cafe-alpha/wascafe/README.md

# wascafe

Wascafe ?
cafe-alpha's sandbox for wasca project, where I put sources for each PCB revision in a separate folder, and also where I learn how to use github related things.

Wasca ?
Sega Saturn multipurpose cartridge, still in development phase.
It will mimic Power Memory / Backup RAM, 1MB ROMs from KoF and Ultraman, and 1M/4M RAM expansion.
More than that, it should emulate Sega Saturn modems, and launch any 3rd party code, for example PseudoSaturn Kai.
Cart is based on Altera MAX 10 FPGA with external SDRAM and internal Nios II soft CPU. 

Wasca main repository can be found here : https://github.com/hitomi2500/wasca/
