cafe-alpha/wascafe/v11/README.md

Second revision, by hitomi2500, Autumn 2015

Specs :
 - MAX10 FPGA (10M04SA or higher)
 - 32MB SDRAM/DDR support
 - USB and bluetooth interfaces
 - STM32 micro controller

Features :
 - Cartridge backup memory (volative)
 - SD (not SDHC) card access
 - RAM expansion (untested ?)

Pictures :
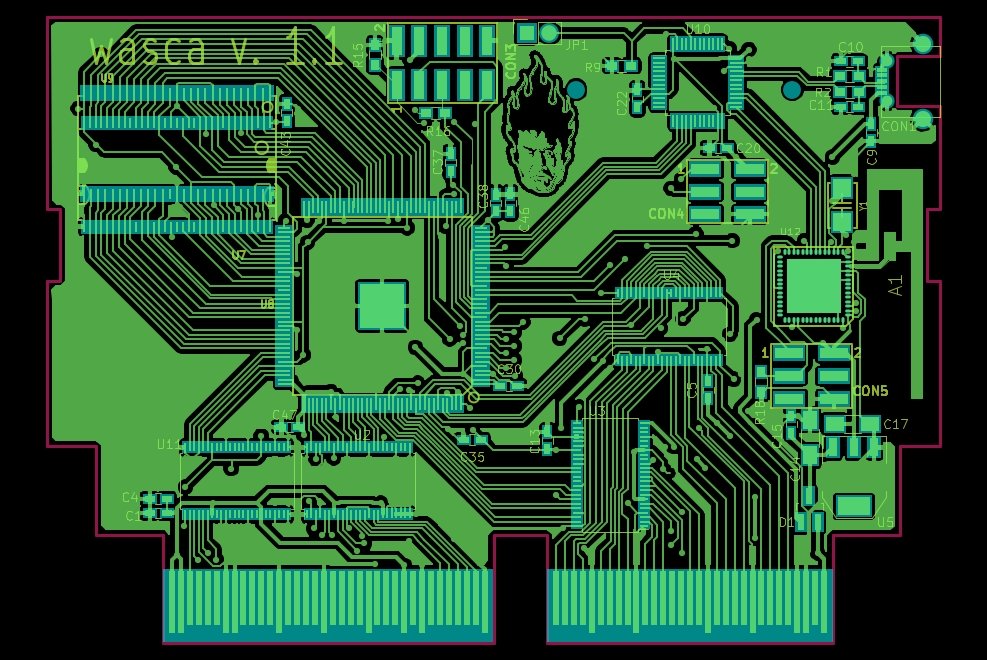
[picture p9: v11/pictures/top.png]

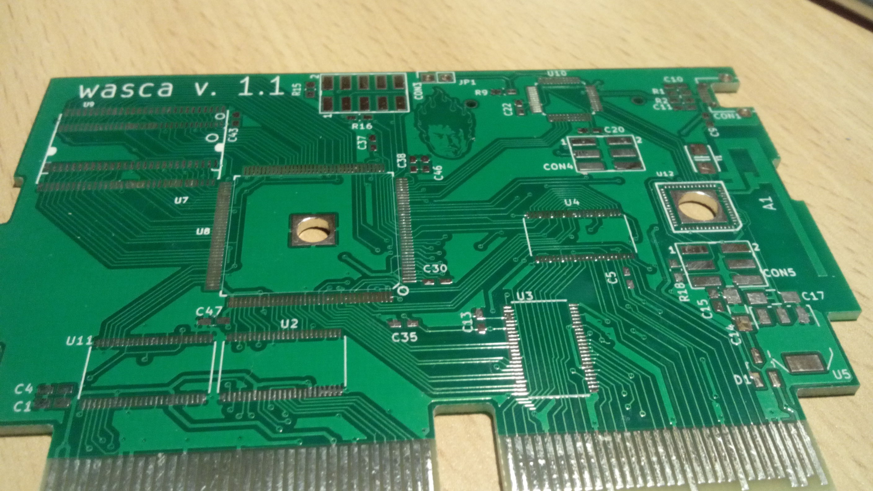
[picture p10: v11/pictures/IMG_20151030_221556_1a.jpg]

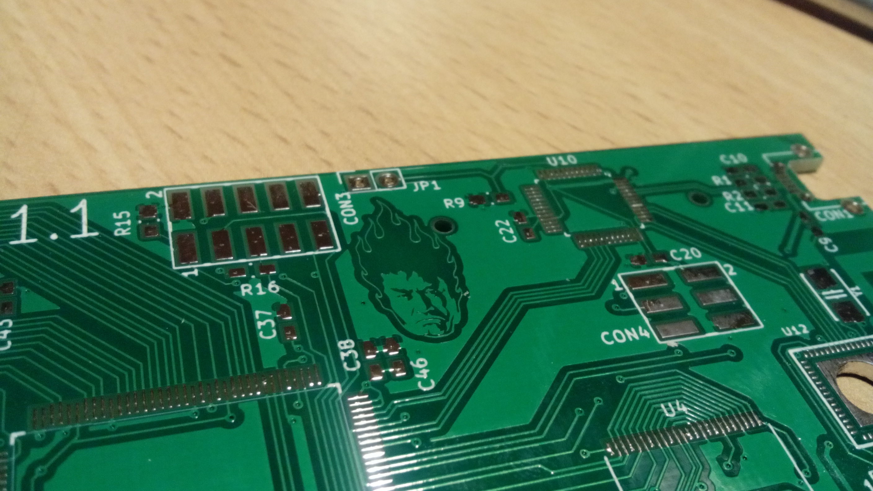
[picture p11: v11/pictures/IMG_20151030_221501_1a.jpg]

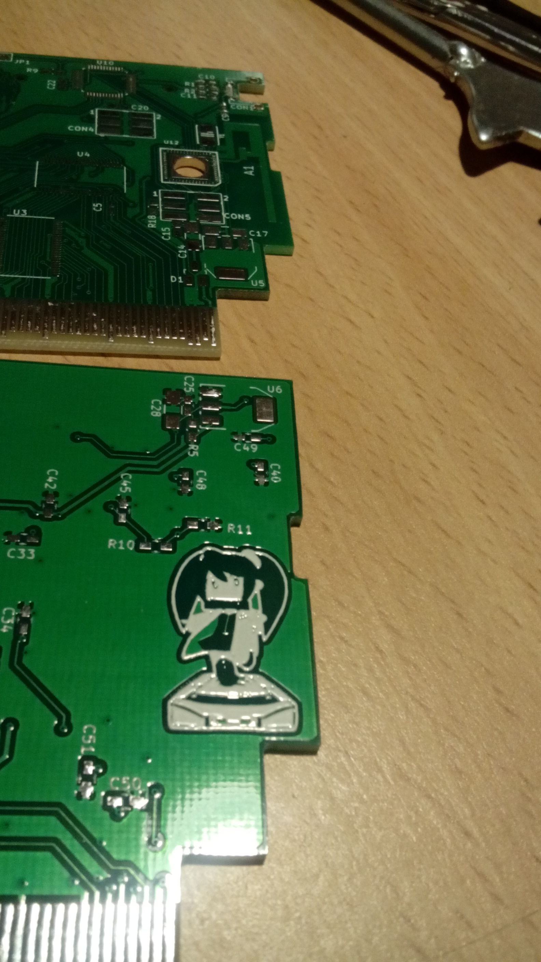
[picture p12: v11/pictures/IMG_20151030_221530_1a.jpg]
