cafe-alpha/wascafe/v10/README.md

First revision, by hitomi2500, Summer 2015

Specs :
 - MAX10 FPGA (10M04SA or higher)
 - 32MB SDRAM support
 - UART + USB interface

Features :
 - Cartridge backup memory (volative)
 - SD (not SDHC) card access
 - RAM expansion (untested ?)

Pictures :
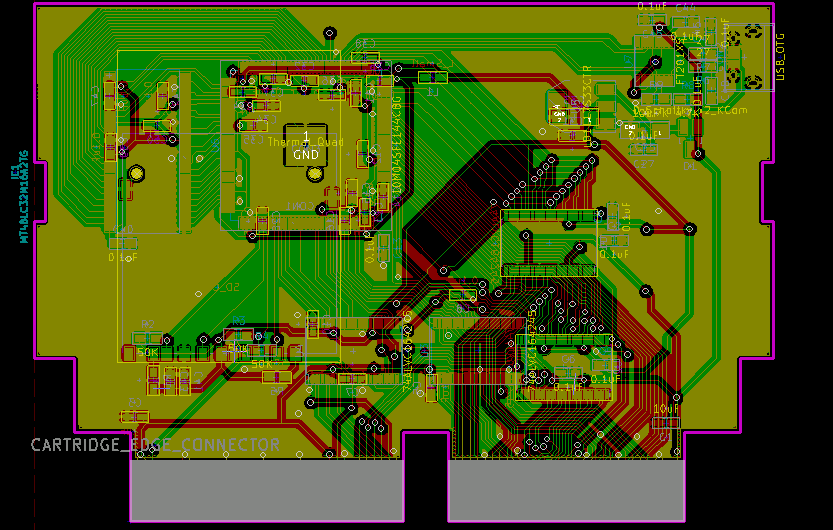
[picture p13: v10/pictures/wasca_pcb.png]

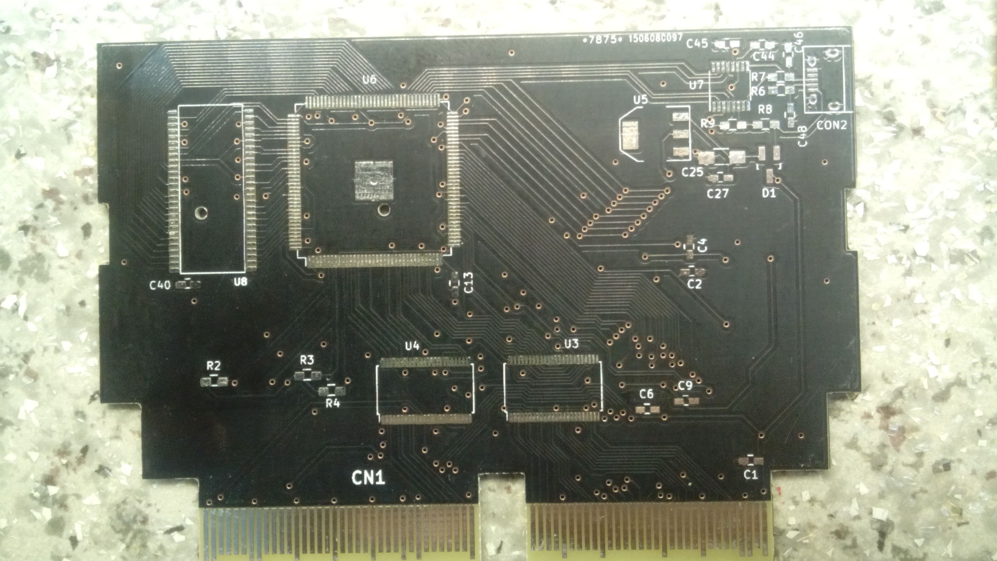
[picture p14: v10/pictures/IMG_20150709_092555.jpg]

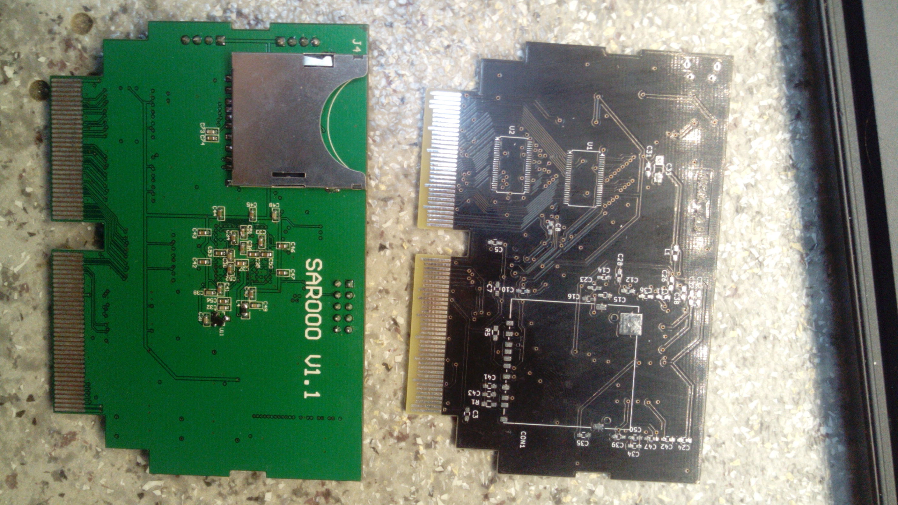
[picture p15: v10/pictures/IMG_20150709_092650.jpg]

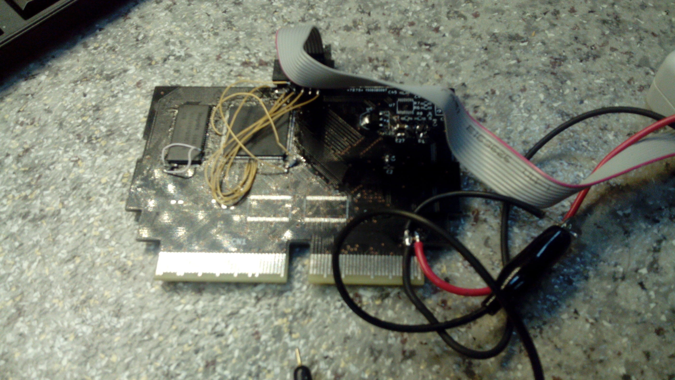
[picture p16: v10/pictures/IMG_20150713_203801.jpg]
