cafe-alpha/wascafe/v13/WascaLoader/screenshots/20200823_v6367.png

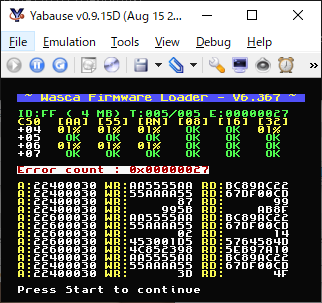
v13/WascaLoader/screenshots/20200823_v6367.png
