cafe-alpha/wascafe/(list of files, cad)

Other CAD files:
v13/r07c_de10_20201014_abus4/wasca_signaltap.stp
