cafe-alpha/wascafe/(list of files, drawings)

Other design files:
v10/board/wasca.dsn
v11/board/wasca.dsn
v12/board/max10_board/max10_board.dsn
v12/board/usbcart/usbcart.dsn
v13/board/wasca.dsn
