cafe-alpha/wascafe/v13/board/wasca.kicad_pcb

## KiCad design v13/board/wasca.kicad_pcb (2020-08-09)

Schematic: wasca.sch

Parts:
C1, C4: 4.7uF; C_0603_HandSoldering
C2, C3, C5, C6, C7, C8, C12, C13, C15, C40, C43, C45, C48, C49, C50, C51, C151, C152, C154: 0.1uF; SM0603
C16: 10uF; C_1206_HandSoldering
C29, C30, C31, C32, C33, C34, C35, C36, C37, C38, C39, C41, C42, C44, C46, C47: 0.1uF; C_0603_HandSoldering
C91, C153: 4.7uF; SM0603
CN1: CARTRIDGE_EDGE_CONNECTOR; CARTRIDGE_EDGE_CONNECTOR2
JTAG1: AVR-JTAG-10; JTAG_Header
LEDG1: LED; LED-3MM
LEDO1: LED; LED_0805
LEDR1: LED; LED-3MM
R12, R13, R14: 10K; R_0603_HandSoldering
R15: 1K; SM0603
R16, R17, R61, R62, R153: 10K; SM0603
R91, R92: 51K; SM0603
R152: 4K7; SM0603
R155, R156: 470; SM0603
R421, R422, R423: 470; R_0603_HandSoldering
RX_LED1: LED; LED_0805
SD1: SD_CARD; sd_socket
SW1: SWITCH_INV; NINJA_SW
TX_LED1: LED; LED_0805
U1, U2, U3, U4, U11: 74ALVC164245; TSSOP-48_6.1x12.5mm_Pitch0.5mm
U5: LD1117S33CTR; SOT-223
U8: 10M08SCE144I7G; TQFP144_ALTERA_HANDSOLDERING
U9: SDRAM_MT48_x16; TSOPII54_SDRAM_MT48
U151: FT232RL; SSOP28
X1, X61: CONN_02X02; Pin_Header_Straight_2x02
X2: CONN_01X02; Pin_Header_Straight_1x02_Pitch2.54mm
X4: CONN_01X04; Pin_Header_Straight_1x04
X151: USB-MB-S; con-usb-USB-MB-S

Connections:
/+3_3V: C5.1, C6.1, C12.1, C13.1, C16.1, C29.1, C30.1, C31.1, C32.1, C33.1, C34.1, C35.1, C36.1, C37.1, C38.1, C39.1, C40.1, C41.1, C42.1, C43.1, C44.1, C45.1, C46.1, C47.1, C48.1, C49.1, C51.1, C91.1, JTAG1.4, R12.1, R13.1, R14.1, R16.1, R17.1, R61.1, R62.1, R91.1, R92.1, RX_LED1.2 (A), SD1.4 (VDD), TX_LED1.2 (A), U1.31 (VCCA), U1.42 (VCCA), U2.31 (VCCA), U2.42 (VCCA), U3.24 (2DIR), U3.31 (VCCA), U3.42 (VCCA), U4.31 (VCCA), U4.42 (VCCA), U5.2 (VO), U8.1 (VCC_ONE), U8.2 (VCCA6), U8.5 (VCCA3), U8.9 (VCCO1A), U8.23 (VCCO1B), U8.31 (VCCO2), U8.34 (VCCA2), U8.35 (VCCA1), U8.36 (VCC_ONE), U8.37 (VCC_ONE), U8.40 (VCCO3), U8.49 (VCCO3), U8.51 (VCC_ONE), U8.67 (VCCO4), U8.71 (VCCA5), U8.72 (VCC_ONE), U8.73 (VCC_ONE), U8.82 (VCCO5), U8.94 (VCCO6), U8.103 (VCCO6), U8.107 (VCCA3), U8.108 (VCC_ONE), U8.109 (VCC_ONE), U8.115 (VCC_ONE), U8.117 (VCCO7), U8.128 (VCCO8), U8.139 (VCCO8), U8.143 (VCCA4), U8.144 (VCC_ONE), U9.1 (VDD), U9.3 (VDD), U9.9 (VDD), U9.14 (VDD), U9.27 (VDD), U9.43 (VDD), U9.49 (VDD), U11.1 (1DIR), U11.31 (VCCA), U11.42 (VCCA), U151.4 (VCCIO), X1.2
/+5V: C1.1, C2.1, C3.1, C4.1, C7.1, C8.1, C15.1, C50.1, C151.1, C152.1, C153.1, CN1.A1 (VCC), CN1.A2 (VCC), CN1.A27 (VCC), CN1.A67 (VCC), CN1.B1 (VCC), CN1.B2 (VCC), CN1.B27 (VCC), CN1.B67 (VCC), U1.7 (VCCB), U1.18 (VCCB), U2.7 (VCCB), U2.18 (VCCB), U3.7 (VCCB), U3.18 (VCCB), U4.7 (VCCB), U4.18 (VCCB), U5.3 (VI), U11.7 (VCCB), U11.18 (VCCB), U151.20 (VCC), X1.4
/ABUS_3V_A16: U2.41 (1A4), U8.120 (DIFFIO_RX_T16p)
/ABUS_3V_A17: U2.40 (1A5), U8.119 (DIFFIO_RX_T10n)
/ABUS_3V_A18: U2.43 (1A3), U8.121 (DEV_CLRn/DIFFIO_RX_T16n)
/ABUS_3V_A19: U8.118 (DIFFIO_RX_T10p), U11.29 (2A5)
/ABUS_3V_A20: U2.44 (1A2), U8.122 (DEV_OE)
/ABUS_3V_A21: U8.114 (IO), U11.30 (2A4)
/ABUS_3V_A22: U2.46 (1A1), U8.123 (VREFB8N0)
/ABUS_3V_A23: U8.113 (IO), U11.32 (2A3)
/ABUS_3V_A24: U2.47 (1A0), U8.124 (DIFFIO_RX_T19p)
/ABUS_3V_A25: U8.112 (VREFB7N0), U11.33 (2A2)
/ABUS_3V_CS0: U3.40 (1A5), U8.132 (DIFFIO_RX_T22p)
/ABUS_3V_CS1: U3.46 (1A1), U8.127 (DIFFIO_RX_T19n)
/ABUS_3V_CS2: U3.41 (1A4), U8.131 (DIFFIO_RX_T20n)
/ABUS_3V_IRQ: U3.35 (2A1), U8.135 (IO)
/ABUS_3V_MUX0: U1.36 (2A0), U1.37 (1A7), U8.141 (DIFFIO_RX_T26n)
/ABUS_3V_MUX1: U1.35 (2A1), U1.38 (1A6), U8.140 (DIFFIO_RX_T26p)
/ABUS_3V_MUX2: R12.2, U1.33 (2A2), U1.40 (1A5), U8.138 (CONF_DONE/DIFFIO_RX_T24n)
/ABUS_3V_MUX3: U1.32 (2A3), U1.41 (1A4), U8.6 (DIFFIO_RX_L1n)
/ABUS_3V_MUX4: U4.32 (2A3), U4.41 (1A4), U8.17 (VREFB1N0)
/ABUS_3V_MUX5: U4.33 (2A2), U4.40 (1A5), U8.15 (JTAGEN)
/ABUS_3V_MUX6: U4.35 (2A1), U4.38 (1A6), U8.14 (DIFFIO_RX_L7p)
/ABUS_3V_MUX7: U4.36 (2A0), U4.37 (1A7), U8.13 (DIFFIO_RX_L7n)
/ABUS_3V_MUX8: U1.30 (2A4), U1.43 (1A3), U8.7 (DIFFIO_RX_L1p)
/ABUS_3V_MUX9: U1.29 (2A5), U1.44 (1A2), U8.8 (DIFFIO_RX_L3n)
/ABUS_3V_MUX10: U1.27 (2A6), U1.46 (1A1), U8.10 (DIFFIO_RX_L3p)
/ABUS_3V_MUX11: U1.26 (2A7), U1.47 (1A0), U8.11 (DIFFIO_RX_L5n)
/ABUS_3V_MUX12: U4.26 (2A7), U4.47 (1A0), U8.26 (CLK0n/DIFFIO_RX_L18n)
/ABUS_3V_MUX13: U4.27 (2A6), U4.46 (1A1), U8.24 (DIFFIO_RX_L16n)
/ABUS_3V_MUX14: U4.29 (2A5), U4.44 (1A2), U8.22 (DIFFIO_RX_L14p)
/ABUS_3V_MUX15: U4.30 (2A4), U4.43 (1A3), U8.21 (DIFFIO_RX_L14n)
/ABUS_3V_MUX_DATA_DIR: U1.1 (1DIR), U4.24 (2DIR), U8.12 (DIFFIO_RX_L5p)
/ABUS_3V_MUX_EN1: U1.25 (2OE), U4.48 (1OE), U8.25 (DIFFIO_RX_L16p)
/ABUS_3V_MUX_EN2: U1.48 (1OE), U4.25 (2OE), U8.27 (CLK0p/DIFFIO_RX_L18p`)
/ABUS_3V_RD: U3.47 (1A0), U8.126 (CONFIG_SEL)
/ABUS_3V_WAIT: U3.36 (2A0), U8.134 (CRC_ERROR/DIFFIO_RX_T22n)
/ABUS_3V_WR0: U3.43 (1A3), U8.130 (DIFFIO_RX_T20p)
/ABUS_3V_WR1: R14.2, U3.44 (1A2), U8.129 (nCONFIG)
/ABUS_A0: CN1.B45 (AA0), U4.12 (1B7)
/ABUS_A1: CN1.A45 (AA1), U1.13 (2B0)
/ABUS_A2: CN1.B44 (AA2), U4.11 (1B6)
/ABUS_A3: CN1.B43 (AA3), U4.9 (1B5)
/ABUS_A4: CN1.B42 (AA4), U4.8 (1B4)
/ABUS_A5: CN1.B40 (AA5), U4.6 (1B3)
/ABUS_A6: CN1.B39 (AA6), U4.5 (1B2)
/ABUS_A7: CN1.B38 (AA7), U4.3 (1B1)
/ABUS_A8: CN1.A40 (AA8), U1.19 (2B4)
/ABUS_A9: CN1.A42 (AA9), U1.17 (2B3)
/ABUS_A10: CN1.A44 (AA10), U1.14 (2B1)
/ABUS_A11: CN1.A43 (AA11), U1.16 (2B2)
/ABUS_A12: CN1.A38 (AA12), U1.22 (2B6)
/ABUS_A13: CN1.A39 (AA13), U1.20 (2B5)
/ABUS_A14: CN1.B37 (AA14), U4.2 (1B0)
/ABUS_A15: CN1.A37 (AA15), U1.23 (2B7)
/ABUS_A16: CN1.B35 (AA16), U2.8 (1B4)
/ABUS_A17: CN1.A35 (AA17), U2.9 (1B5)
/ABUS_A18: CN1.B34 (AA18), U2.6 (1B3)
/ABUS_A19: CN1.A34 (AA19), U11.20 (2B5)
/ABUS_A20: CN1.B33 (AA20), U2.5 (1B2)
/ABUS_A21: CN1.A33 (AA21), U11.19 (2B4)
/ABUS_A22: CN1.B32 (AA22), U2.3 (1B1)
/ABUS_A23: CN1.A32 (AA23), U11.17 (2B3)
/ABUS_A24: CN1.B31 (AA24), U2.2 (1B0)
/ABUS_A25: CN1.A31 (AA25), U11.16 (2B2)
/ABUS_CS0: CN1.A47 (ACS0), U3.9 (1B5)
/ABUS_CS1: CN1.B48 (ACS1), U3.3 (1B1)
/ABUS_CS2: CN1.A48 (ACS2), U3.8 (1B4)
/ABUS_D0: CN1.A55 (AD0), U1.12 (1B7)
/ABUS_D1: CN1.A56 (AD1), U1.11 (1B6)
/ABUS_D2: CN1.A57 (AD2), U1.9 (1B5)
/ABUS_D3: CN1.A58 (AD3), U1.8 (1B4)
/ABUS_D4: CN1.B58 (AD4), U4.17 (2B3)
/ABUS_D5: CN1.B57 (AD5), U4.16 (2B2)
/ABUS_D6: CN1.B56 (AD6), U4.14 (2B1)
/ABUS_D7: CN1.B55 (AD7), U4.13 (2B0)
/ABUS_D8: CN1.A60 (AD8), U1.6 (1B3)
/ABUS_D9: CN1.A61 (AD9), U1.5 (1B2)
/ABUS_D10: CN1.A62 (AD10), U1.3 (1B1)
/ABUS_D11: CN1.A63 (AD11), U1.2 (1B0)
/ABUS_D12: CN1.B63 (AD12), U4.23 (2B7)
/ABUS_D13: CN1.B62 (AD13), U4.22 (2B6)
/ABUS_D14: CN1.B61 (AD14), U4.20 (2B5)
/ABUS_D15: CN1.B60 (AD15), U4.19 (2B4)
/ABUS_IRQ: CN1.B53 (AIRQ), U3.14 (2B1)
/ABUS_RD: CN1.B47 (ARD), U3.2 (1B0)
/ABUS_WAIT: CN1.B52 (AWAIT), U3.13 (2B0)
/ABUS_WR0: CN1.A49 (AWR0), U3.6 (1B3)
/ABUS_WR1: CN1.B49 (AWR1), U3.5 (1B2)
/DDR_SPARE1: LEDO1.2 (A), U8.99 (DIFFIO_RX_R27p)
/DDR_SPARE2: R62.2, U8.100 (DIFFIO_RX_R28p), X61.3
/DDR_SPARE3: R61.2, SW1.2, U8.101 (DIFFIO_RX_R27n), X61.1
/IBCK: CN1.A5 (IBCK), U11.5 (1B2)
/IBCK_3V: U8.106 (DIFFIO_RX_R33n), U11.44 (1A2)
/ILRCK: CN1.A6 (ILRCK), U11.12 (1B7)
/ILRCK_3V: U8.110 (DIFFIO_RX_T1p), U11.37 (1A7)
/ISD: CN1.A4 (ISD), U11.3 (1B1)
/ISD_3V: U8.105 (DIFFIO_RX_R33p), U11.46 (1A1)
/JTAG_TCK: JTAG1.1, R15.1, U8.18 (TCK/DIFFIO_RX_L11p)
/JTAG_TDI: JTAG1.9, R17.2, U8.19 (TDI/DIFFIO_RX_L12n)
/JTAG_TDO: JTAG1.3, U8.20 (TDO/DIFFIO_RX_L12p)
/JTAG_TMS: JTAG1.5, R16.2, U8.16 (TMS/DIFFIO_RX_L11n)
/LEDG1: LEDG1.2 (A), U8.97 (VREFB6N0)
/LEDR1: LEDR1.2 (A), U8.98 (DPCLK2/DIFFIO_RX_R26n)
/M10_SPARE1: U8.29 (CLK1p/DIFFIO_RX_L20p), X2.1
/M10_SPARE2: U8.30 (VREFB2N0), X2.2
/M10_UART_RX: U8.32 (PLL_L_CLKOUTn/DIFFIO_RX_L27n), U151.1 (TXD)
/M10_UART_TX: U8.33 (PLL_L_CLKOUTp/DIFFIO_RX_L27p), U151.5 (RXD)
/RESET: CN1.A3 (SYSRES), U11.13 (2B0)
/RESET_3V: U8.111 (DIFFIO_RX_T1n), U11.36 (2A0)
/SCSPCLK: CN1.A7 (SCSPCLK), U2.23 (2B7)
/SCSPCLK_3V: U2.26 (2A7), U8.28 (CLK1n/DIFFIO_RX_L20n)
/SDR_A0: U8.65 (DIFFIO_TX_RX_B23p), U9.23 (A0)
/SDR_A1: U8.66 (IO), U9.24 (A1)
/SDR_A2: U8.69 (DIFFIO_TX_RX_B27n), U9.25 (A2)
/SDR_A3: U8.70 (DIFFIO_TX_RX_B27p), U9.26 (A3)
/SDR_A4: U8.96 (DPCLK3/DIFFIO_RX_R26p), U9.29 (A4)
/SDR_A5: U8.93 (DIFFIO_RX_R18n), U9.30 (A5)
/SDR_A6: U8.92 (DIFFIO_RX_R18p), U9.31 (A6)
/SDR_A7: U8.91 (CLK3n/DIFFIO_RX_R16n), U9.32 (A7)
/SDR_A8: U8.90 (CLK3p/DIFFIO_RX_R16p), U9.33 (A8)
/SDR_A9: U8.89 (CLK2n/DIFFIO_RX_R14n), U9.34 (A9)
/SDR_A10: U8.64 (DIFFIO_TX_RX_B23n), U9.22 (A10)
/SDR_A11: U8.88 (CLK2p/DIFFIO_RX_R14p), U9.35 (A11)
/SDR_A12: U8.87 (DIFFIO_RX_R10n), U9.36 (A12)
/SDR_BA0: U8.61 (VREFB4N0), U9.20 (BA0)
/SDR_BA1: U8.62 (IO), U9.21 (BA1)
/SDR_CAS: U8.58 (DIFFIO_TX_RX_B14p), U9.17 (nCAS)
/SDR_CKE: U8.86 (DIFFIO_RX_R11n), U9.37 (CKE)
/SDR_CLK: U8.85 (DIFFIO_RX_R10p), U9.38 (CLK)
/SDR_CS: U8.60 (DIFFIO_TX_RX_B16p), U9.19 (nCS)
/SDR_DQ0: U8.45 (DIFFIO_TX_RX_B5p), U9.2 (DQ0)
/SDR_DQ1: U8.46 (DIFFIO_TX_RX_B7n), U9.4 (DQ1)
/SDR_DQ2: U8.47 (DIFFIO_TX_RX_B7p), U9.5 (DQ2)
/SDR_DQ3: U8.48 (VREFB3N0), U9.7 (DQ3)
/SDR_DQ4: U8.50 (DIFFIO_TX_RX_B9n), U9.8 (DQ4)
/SDR_DQ5: U8.52 (DIFFIO_TX_RX_B9p), U9.10 (DQ5)
/SDR_DQ6: U8.54 (IO), U9.11 (DQ6)
/SDR_DQ7: U8.55 (DIFFIO_TX_RX_B12n), U9.13 (DQ7)
/SDR_DQ8: U8.81 (DIFFIO_RX_R7n), U9.42 (DQ8)
/SDR_DQ9: U8.80 (VREFB5N0), U9.44 (DQ9)
/SDR_DQ10: U8.79 (DIFFIO_RX_R7p), U9.45 (DQ10)
/SDR_DQ11: U8.78 (IO), U9.47 (DQ11)
/SDR_DQ12: U8.77 (DIFFIO_RX_R1n), U9.48 (DQ12)
/SDR_DQ13: U8.76 (DIFFIO_RX_R2n), U9.50 (DQ13)
/SDR_DQ14: U8.75 (DIFFIO_RX_R1p), U9.51 (DQ14)
/SDR_DQ15: U8.74 (DIFFIO_RX_R2p), U9.53 (DQ15)
/SDR_DQMH: U8.84 (DIFFIO_RX_R11p), U9.39 (UDQM-DQMH)
/SDR_DQML: U8.56 (DIFFIO_TX_RX_B12p), U9.15 (LDQM-DQML)
/SDR_RAS: U8.59 (DIFFIO_TX_RX_B16n), U9.18 (nRAS)
/SDR_WE: U8.57 (DIFFIO_TX_RX_B14n), U9.16 (nWE)
/SD_CLK: SD1.5 (CLK), U8.41 (DIFFIO_TX_RX_B3n), X4.3
/SD_CS: SD1.1 (CD/DAT3), U8.38 (DIFFIO_TX_RX_B1n), X4.1
/SD_DIN: SD1.2 (CMD), U8.39 (DIFFIO_TX_RX_B1p), X4.2
/SD_DOUT: R91.2, SD1.7 (DAT0), U8.44 (DIFFIO_TX_RX_B5n), X4.4
/SSEL: CN1.B3 (SSEL), U11.2 (1B0)
/SSEL_3V: U8.102 (DIFFIO_RX_R28n), U11.47 (1A0)
/UART_RXING: R155.1, U151.23 (CBUS0)
/UART_TXING: R156.1, U151.22 (CBUS1)
/WAIT_ENABLE: R13.2, U3.25 (2OE), U8.136 (nSTATUS/DIFFIO_RX_T24p)
GND: C1.2, C2.2, C3.2, C4.2, C5.2, C6.2, C7.2, C8.2, C12.2, C13.2, C15.2, C16.2, C29.2, C30.2, C31.2, C32.2, C33.2, C34.2, C35.2, C36.2, C37.2, C38.2, C39.2, C40.2, C41.2, C42.2, C43.2, C44.2, C45.2, C46.2, C47.2, C48.2, C49.2, C50.2, C51.2, C91.2, C151.2, C152.2, C153.2, C154.2, CN1.A8 (GND), CN1.A13 (GND), CN1.A18 (GND), CN1.A23 (GND), CN1.A29 (GND), CN1.A36 (GND), CN1.A41 (GND), CN1.A46 (GND), CN1.A54 (GND), CN1.A59 (GND), CN1.A64 (GND), CN1.A65 (GND), CN1.B7 (GND), CN1.B8 (GND), CN1.B13 (GND), CN1.B18 (GND), CN1.B23 (GND), CN1.B29 (GND), CN1.B36 (GND), CN1.B41 (GND), CN1.B46 (GND), CN1.B54 (GND), CN1.B59 (GND), CN1.B64 (GND), CN1.B65 (GND), JTAG1.2, JTAG1.10, R15.2, R153.1, R421.2, R422.2, R423.2, SD1.3 (VSS), SD1.6 (VSS), SD1.12 (SHELL1), SD1.13 (SHELL2), SD1.14 (SHELL3), SD1.15 (SHELL4), SD1.16 (CD_GND), SD1.17 (WP_GND), SW1.3, U1.4 (GND), U1.10 (GND), U1.15 (GND), U1.21 (GND), U1.24 (2DIR), U1.28 (GND), U1.34 (GND), U1.39 (GND), U1.45 (GND), U2.1 (1DIR), U2.4 (GND), U2.10 (GND), U2.11 (1B6), U2.12 (1B7), U2.13 (2B0), U2.14 (2B1), U2.15 (GND), U2.16 (2B2), U2.17 (2B3), U2.19 (2B4), U2.20 (2B5), U2.21 (GND), U2.22 (2B6), U2.24 (2DIR), U2.25 (2OE), U2.28 (GND), U2.34 (GND), U2.39 (GND), U2.45 (GND), U2.48 (1OE), U3.1 (1DIR), U3.4 (GND), U3.10 (GND), U3.11 (1B6), U3.12 (1B7), U3.15 (GND), U3.21 (GND), U3.26 (2A7), U3.27 (2A6), U3.28 (GND), U3.29 (2A5), U3.30 (2A4), U3.32 (2A3), U3.33 (2A2), U3.34 (GND), U3.39 (GND), U3.45 (GND), U3.48 (1OE), U4.1 (1DIR), U4.4 (GND), U4.10 (GND), U4.15 (GND), U4.21 (GND), U4.28 (GND), U4.34 (GND), U4.39 (GND), U4.45 (GND), U5.1 (GND), U8.3 (GND), U8.4 (GND), U8.42 (GND), U8.53 (GND), U8.63 (GND), U8.68 (GND), U8.83 (GND), U8.95 (GND), U8.104 (GND), U8.116 (GND), U8.125 (GND), U8.133 (GND), U8.137 (GND), U8.142 (GND), U8.145 (EXP_PAD), U9.6 (GND), U9.12 (GND), U9.28 (GND), U9.41 (GND), U9.46 (GND), U9.52 (GND), U9.54 (GND), U11.4 (GND), U11.6 (1B3), U11.8 (1B4), U11.9 (1B5), U11.10 (GND), U11.11 (1B6), U11.14 (2B1), U11.15 (GND), U11.21 (GND), U11.22 (2B6), U11.23 (2B7), U11.24 (2DIR), U11.25 (2OE), U11.28 (GND), U11.34 (GND), U11.39 (GND), U11.45 (GND), U11.48 (1OE), U151.7 (GND), U151.18 (GND), U151.21 (GND), U151.25 (AGND), U151.26 (TEST), X1.1, X1.3, X61.2, X61.4, X151.GND
unnamed: C154.1, U151.17 (3V3OUT)
unnamed: LEDG1.1 (K), R422.1
unnamed: LEDO1.1 (K), R423.1
unnamed: LEDR1.1 (K), R421.1
unnamed: R92.2, SD1.10 (CARD_DETECT), U8.43 (DIFFIO_TX_RX_B3p)
unnamed: R152.1, R153.2, U151.19 (~RESET~)
unnamed: R152.2, X151.VBUS
unnamed: R155.2, RX_LED1.1 (K)
unnamed: R156.2, TX_LED1.1 (K)
unnamed: U151.15 (USBD+), X151.D+
unnamed: U151.16 (USBD-), X151.D-

Notes on the sheet:
Spare for DDR : - DDR_DQSH - DDR_DQSL - DDR_CLKN
Extra
External 5V power supply + 3V3 power output/check
SDRAM : shares 3V3 with MAX10 DDR : requires 2V5 power supply
--- Changelog --- V1.0 hitomi2500 : - Initial version with 10M04SFE, SDRAM, FT201XS V1.1 hitomi2500 : - Both DDR/SDRAM support - Added USB and bluetooth support - Sound I/O mapped to MAX10 V1.2 cafe-alpha : - Changed PCB shape and ICs position in order to fit Action Replay case - Changed MAX10 chip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
The power descriptor in the internal EEPROM of the FT232R should be programmed to a value of zero (self-powered).
Connection with PC
TODO: add footprint to help orientation for 3V3 buffers TODO: pin B45 isn't A0 and consequently all address pins must be shifted and re-routed. TODO: restrict address lines count to A0-A23 (no plan to use A24) TODO: Use PLL output pin (32 or 33) for SDRAM clock. Probably requires to change SDRAM ch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

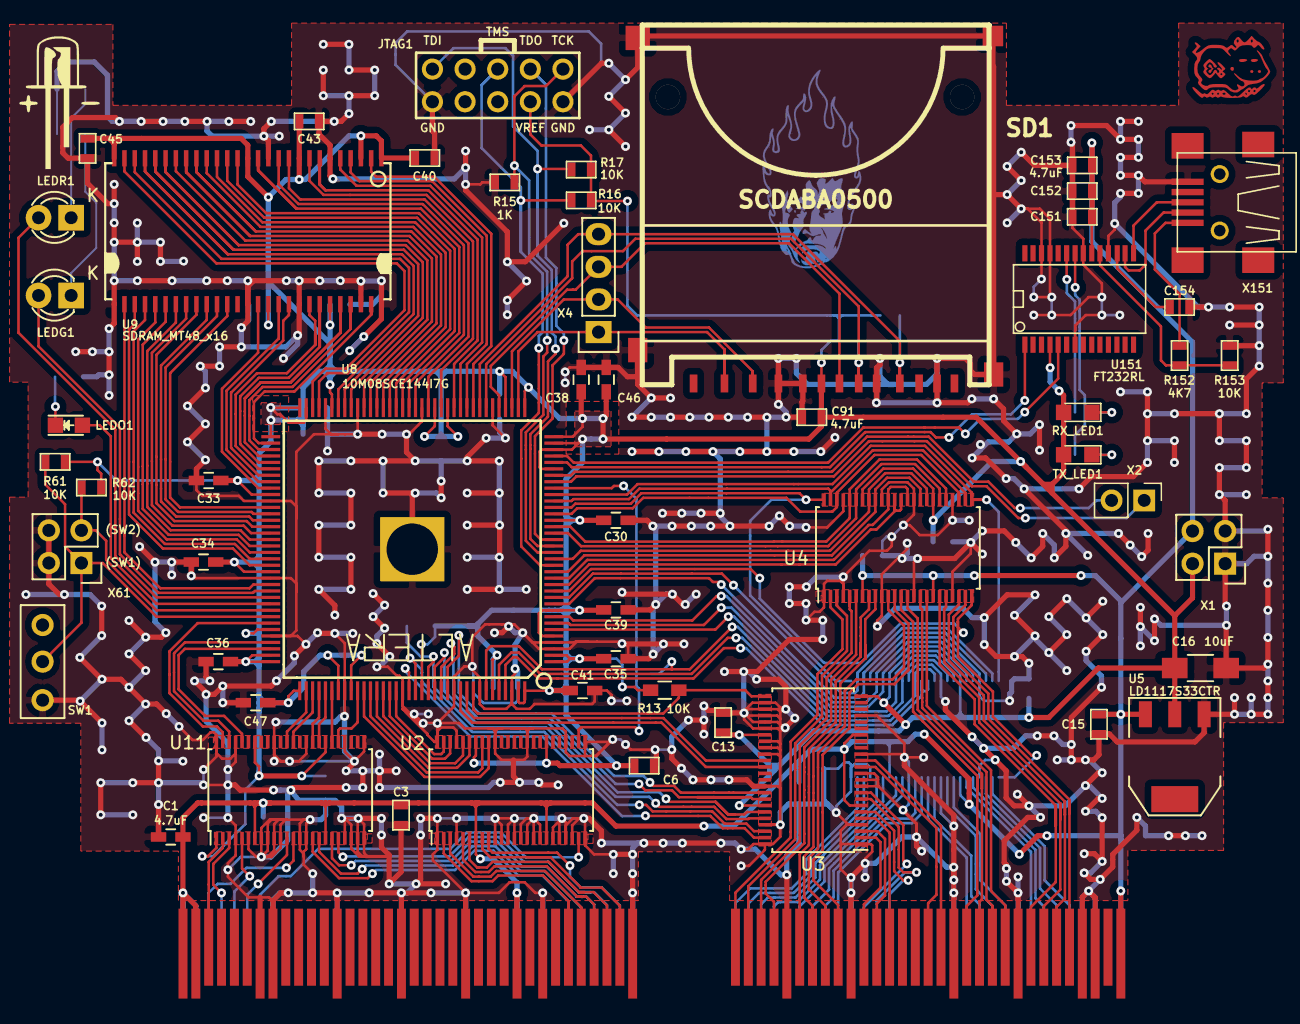
[picture p18: board v13/board/wasca.kicad_pcb from above]

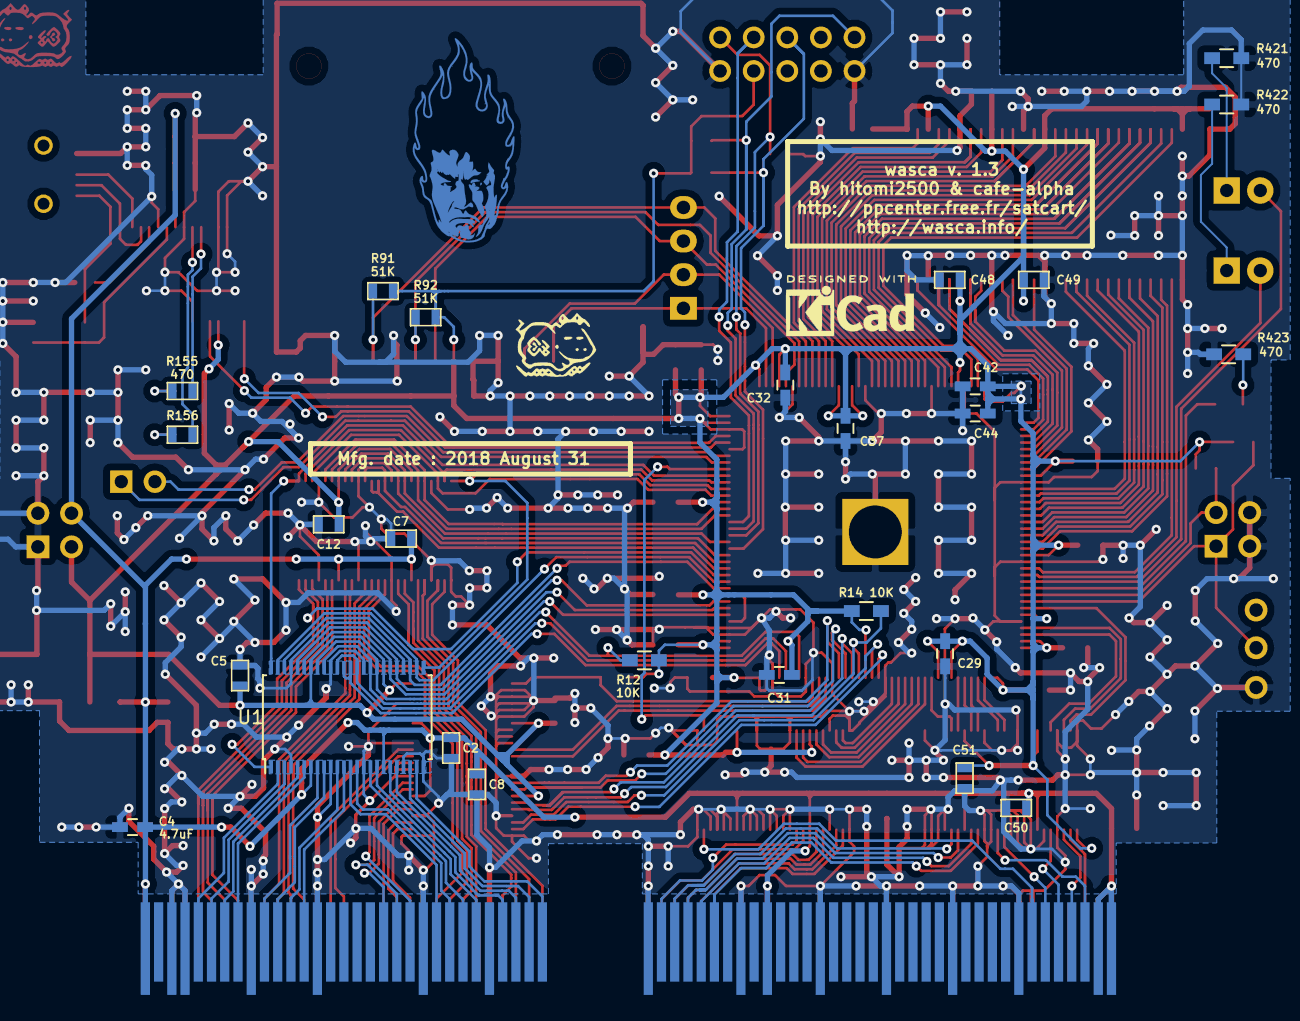
[picture p19: board v13/board/wasca.kicad_pcb from below]

Board: 2 copper layers, 80 parts (26 on the bottom side), 172 nets.
