cafe-alpha/wascafe/v11/board/wasca.kicad_pcb

## KiCad design v11/board/wasca.kicad_pcb (2016-08-04, an earlier design)

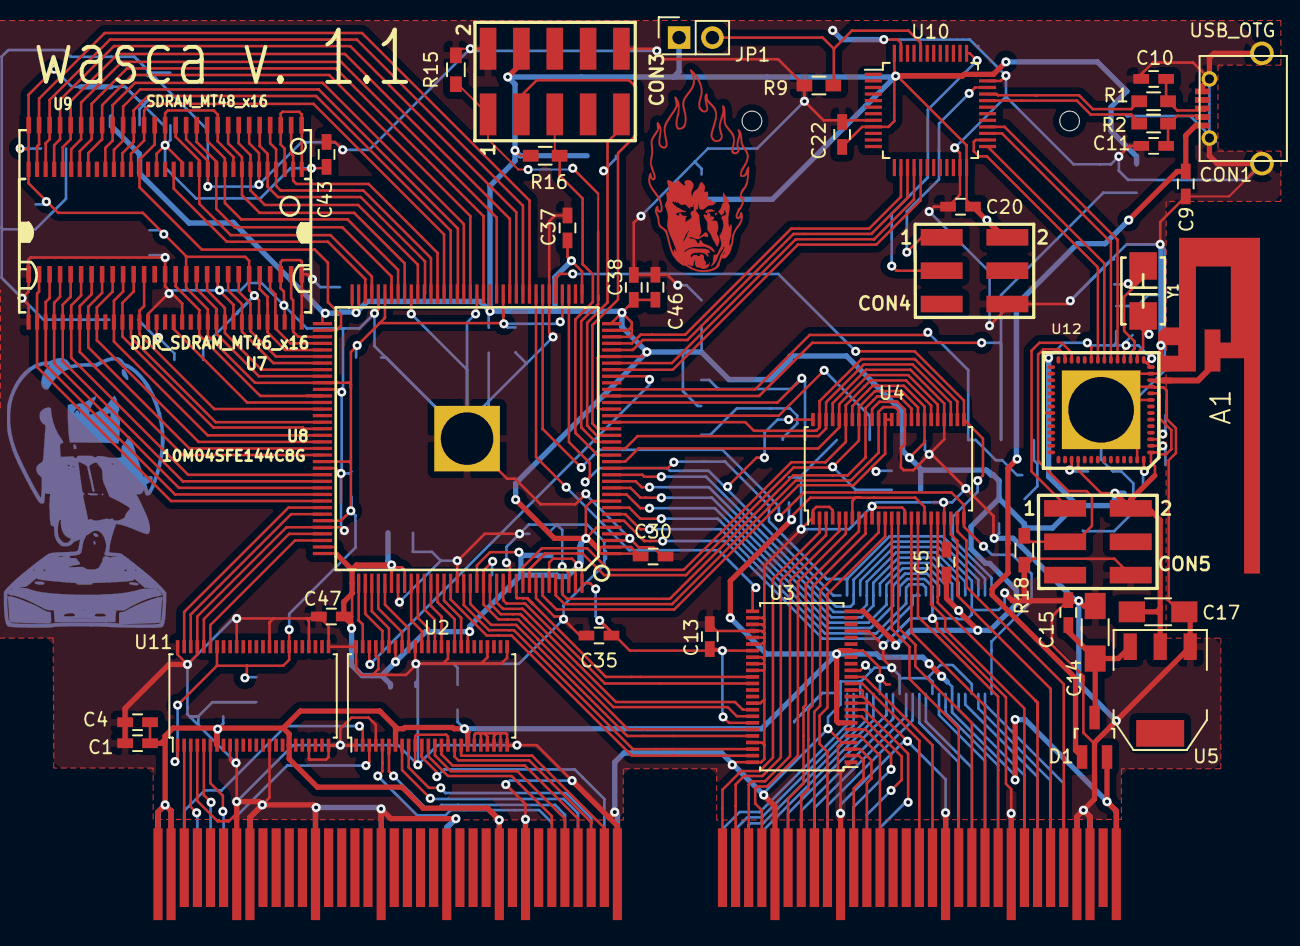
[picture p20: board v11/board/wasca.kicad_pcb from above]

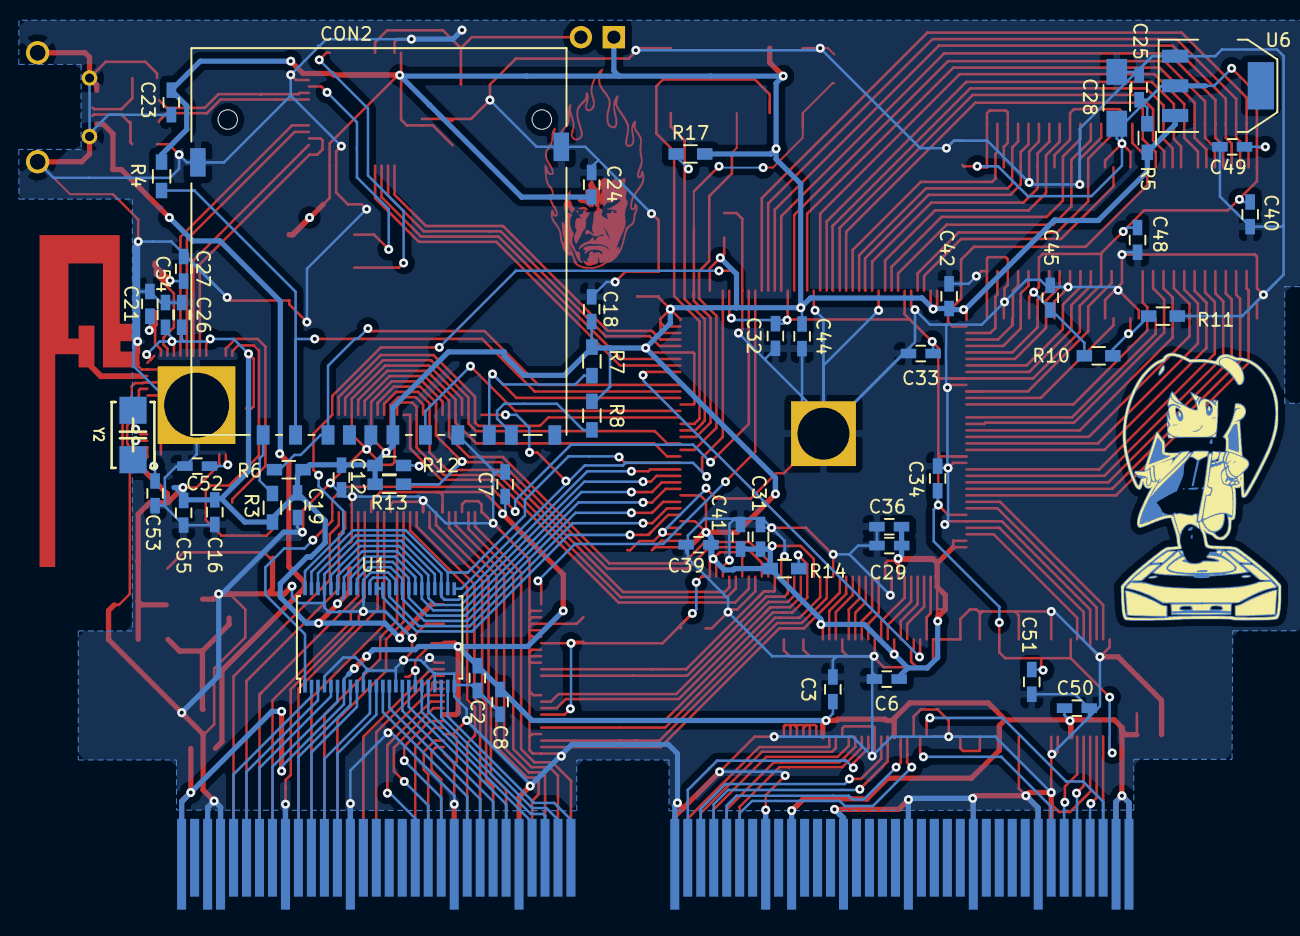
[picture p21: board v11/board/wasca.kicad_pcb from below]

Board: 2 copper layers, 96 parts (52 on the bottom side), 183 nets.

Parts:
A1: ANT; PCB_IF_ANT_2.4G
C1: 10uF; C_0603_HandSoldering
C2, C3, C4, C5, C6, C7, C8, C9, C12, C13, C15, C16, C19, C20, C21, C22, C23, C24, C25, C29, C30, C31, C32, C33, C34, C35, C36, C37, C38, C39, C40, C41, C42, C43, C44, C45, C46, C47, C48, C49, C50, C51, C54, C55: 0.1uF; C_0603_HandSoldering
C10, C11, C26, C27: 47pF; C_0603_HandSoldering
C14, C17, C28: 10uF; C_1206_HandSoldering
C18, C52, C53: 1uF; C_0603_HandSoldering
CN1: CARTRIDGE_EDGE_CONNECTOR; CARTRIDGE_EDGE_CONNECTOR2
CON1: USB_OTG; MicroUSB
CON2: SD_Card; SD_Card_Receptacle
CON3: AVR-JTAG-10; Pinhead_2x5_SMD
CON4, CON5: AVR-ISP-6; Pinhead_2x3_SMD
D1: D_Schottky_x2_KCom_AAK; SOT-23_Handsoldering
JP1: JUMPER; Pin_Header_Straight_2x01
R1, R2: 33; R_0603_HandSoldering
R3, R4, R6, R7, R8, R12, R13, R14: 50K; R_0603_HandSoldering
R5: DO NOT PLACE; R_0603_HandSoldering
R9, R15: 1K; R_0603_HandSoldering
R10, R11: 4.7K; R_0603_HandSoldering
R16, R17: 10K; R_0603_HandSoldering
R18: 12K; R_0603_HandSoldering
U1, U2, U3, U4, U11: 74ALVC164245; TSSOP-48_6.1x12.5mm_Pitch0.5mm
U5: LD1117S33CTR; SOT-223
U6: LD1117S25CTR; SOT-223
U7: DDR_SDRAM_MT46_x16; TSOP66_JEDEC_DDR_SDRAM
U8: 10M04SFE144C8G; TQFP144_ALTERA_HANDSOLDERING
U9: SDRAM_MT48_x16; TSOPII54_SDRAM_MT48
U10: STM32F042C6T6; LQFP-48_7x7mm_Pitch0.5mm
U12: CY8C4127LQI-BL473; QFN56_EXP
Y1: 24MHz; Crystal_5x3.2mm
Y2: 32678Hz; Crystal_5x3.2mm

Connections:
/+3_3V: C5.1, C6.1, C12.1, C13.1, C16.1, C17.1, C18.1, C19.1, C20.1, C21.1, C22.1, C23.1, C24.1, C29.1, C30.1, C31.1, C35.1, C36.1, C37.1, C38.1, C39.1, C41.1, C42.1, C44.1, C46.1, C47.1, C54.1, C55.1, CON2.4, CON3.4, CON4.2, CON5.2, JP1.1, R3.1, R4.1, R5.2, R6.1, R7.1, R8.1, R12.1, R13.1, R14.1, R16.1, R17.1, U1.31, U1.42, U2.31, U2.42, U3.24, U3.31, U3.42, U4.31, U4.42, U5.2, U6.3, U8.1, U8.2, U8.5, U8.9, U8.23, U8.31, U8.34, U8.35, U8.36, U8.37, U8.51, U8.71, U8.72, U8.73, U8.107, U8.108, U8.109, U8.115, U8.117, U8.128, U8.139, U8.143, U8.144, U10.9, U10.24, U10.36, U10.48, U12.1, U12.10, U12.14, U12.15, U12.18, U12.23, U12.36, U12.46
/+5V: C1.1, C2.1, C3.1, C4.1, C7.1, C8.1, C50.1, CN1.A1, CN1.A2, CN1.A27, CN1.A67, CN1.B1, CN1.B2, CN1.B27, CN1.B67, D1.2, U1.7, U1.18, U2.7, U2.18, U3.7, U3.18, U4.7, U4.18, U11.7, U11.18
/ABUS_3V_A16: U2.32, U8.123
/ABUS_3V_A17: U2.38, U8.118
/ABUS_3V_A18: U2.33, U8.122
/ABUS_3V_A19: U2.40, U8.114
/ABUS_3V_A20: U2.35, U8.121
/ABUS_3V_A21: U2.41, U8.113
/ABUS_3V_A22: U2.36, U8.120
/ABUS_3V_A23: U2.43, U8.112
/ABUS_3V_A24: U2.37, U8.119
/ABUS_3V_A25: U2.44, U8.111
/ABUS_3V_CS0: R14.2, U3.43, U8.129
/ABUS_3V_CS1: U3.46, U8.126
/ABUS_3V_CS2: U3.41, U8.130
/ABUS_3V_IRQ: U3.35, U8.134
/ABUS_3V_MUX0: U1.36, U1.37, U8.6
/ABUS_3V_MUX1: U1.35, U1.38, U8.7
/ABUS_3V_MUX2: U1.33, U1.40, U8.8
/ABUS_3V_MUX3: U1.32, U1.41, U8.10
/ABUS_3V_MUX4: R13.2, U4.32, U4.41, U8.136
/ABUS_3V_MUX5: U4.33, U4.40, U8.141
/ABUS_3V_MUX6: U4.35, U4.38, U8.140
/ABUS_3V_MUX7: R12.2, U4.36, U4.37, U8.138
/ABUS_3V_MUX8: U1.30, U1.43, U8.11
/ABUS_3V_MUX9: U1.29, U1.44, U8.12
/ABUS_3V_MUX10: U1.27, U1.46, U8.13
/ABUS_3V_MUX11: U1.26, U1.47, U8.14
/ABUS_3V_MUX12: U4.26, U4.47, U8.21
/ABUS_3V_MUX13: U4.27, U4.46, U8.17
/ABUS_3V_MUX14: U4.29, U4.44, U8.15
/ABUS_3V_MUX15: U4.30, U4.43, U8.135
/ABUS_3V_MUX_DATA_DIR: U1.1, U4.24, U8.43
/ABUS_3V_MUX_EN1: U1.25, U4.48, U8.39
/ABUS_3V_MUX_EN2: U1.48, U4.25, U8.41
/ABUS_3V_RD: U3.47, U8.124
/ABUS_3V_WAIT: U3.36, U8.132
/ABUS_3V_WR0: U3.40, U8.131
/ABUS_3V_WR1: U3.44, U8.127
/ABUS_A0: CN1.B45, U4.12
/ABUS_A1: CN1.A45, U1.13
/ABUS_A2: CN1.B44, U4.11
/ABUS_A3: CN1.B43, U4.9
/ABUS_A4: CN1.B42, U4.8
/ABUS_A5: CN1.B40, U4.6
/ABUS_A6: CN1.B39, U4.5
/ABUS_A7: CN1.B38, U4.3
/ABUS_A8: CN1.A40, U1.19
/ABUS_A9: CN1.A42, U1.17
/ABUS_A10: CN1.A44, U1.14
/ABUS_A11: CN1.A43, U1.16
/ABUS_A12: CN1.A38, U1.22
/ABUS_A13: CN1.A39, U1.20
/ABUS_A14: CN1.B37, U4.2
/ABUS_A15: CN1.A37, U1.23
/ABUS_A16: CN1.B35, U2.17
/ABUS_A17: CN1.A35, U2.11
/ABUS_A18: CN1.B34, U2.16
/ABUS_A19: CN1.A34, U2.9
/ABUS_A20: CN1.B33, U2.14
/ABUS_A21: CN1.A33, U2.8
/ABUS_A22: CN1.B32, U2.13
/ABUS_A23: CN1.A32, U2.6
/ABUS_A24: CN1.B31, U2.12
/ABUS_A25: CN1.A31, U2.5
/ABUS_CS0: CN1.A47, U3.6
/ABUS_CS1: CN1.B48, U3.3
/ABUS_CS2: CN1.A48, U3.8
/ABUS_D0: CN1.A55, U1.12
/ABUS_D1: CN1.A56, U1.11
/ABUS_D2: CN1.A57, U1.9
/ABUS_D3: CN1.A58, U1.8
/ABUS_D4: CN1.B58, U4.17
/ABUS_D5: CN1.B57, U4.16
/ABUS_D6: CN1.B56, U4.14
/ABUS_D7: CN1.B55, U4.13
/ABUS_D8: CN1.A60, U1.6
/ABUS_D9: CN1.A61, U1.5
/ABUS_D10: CN1.A62, U1.3
/ABUS_D11: CN1.A63, U1.2
/ABUS_D12: CN1.B63, U4.23
/ABUS_D13: CN1.B62, U4.22
/ABUS_D14: CN1.B61, U4.20
/ABUS_D15: CN1.B60, U4.19
/ABUS_IRQ: CN1.B53, U3.14
/ABUS_RD: CN1.B47, U3.2
/ABUS_WAIT: CN1.B52, U3.13
/ABUS_WR0: CN1.A49, U3.9
/ABUS_WR1: CN1.B49, U3.5
/BLUE_CLK: U10.26, U12.22
/BLUE_MISO: U10.27, U12.20
/BLUE_MOSI: U10.28, U12.19
/BLUE_SS: U10.25, U12.21
/COMM_CLK: U8.32, U10.15
/COMM_MISO: U8.30, U10.16
/COMM_MOSI: U8.29, U10.17
/COMM_SS: U8.33, U10.14
/DDR_CLKN: U7.46, U8.88
/DDR_DQSH: U7.51, U8.85
/DDR_DQSL: U7.16, U8.70
/IBCK: CN1.A5, U11.5
/IBCK_3V: U8.105, U11.44
/ILRCK: CN1.A6, U11.6
/ILRCK_3V: U8.106, U11.43
/ISD: CN1.A4, U11.3
/ISD_3V: U8.102, U11.46
/JTAG_TCK: CON3.1, R15.1, U8.18
/JTAG_TDI: CON3.9, R17.2, U8.19
/JTAG_TDO: CON3.3, U8.20
/JTAG_TMS: CON3.5, R16.2, U8.16
/RESET: CN1.A3, U2.2
/RESET_3V: U2.47, U8.110
/SCSPCLK: CN1.A7, U2.3
/SCSPCLK_3V: U2.46, U8.28
/SDR_A0: U7.29, U8.48, U9.23
/SDR_A1: U7.30, U8.47, U9.24
/SDR_A2: U7.31, U8.46, U9.25
/SDR_A3: U7.32, U8.45, U9.26
/SDR_A4: U7.35, U8.100, U9.29
/SDR_A5: U7.36, U8.99, U9.30
/SDR_A6: U7.37, U8.98, U9.31
/SDR_A7: U7.38, U8.97, U9.32
/SDR_A8: U7.39, U8.96, U9.33
/SDR_A9: U7.40, U8.93, U9.34
/SDR_A10: U7.28, U8.50, U9.22
/SDR_A11: U7.41, U8.92, U9.35
/SDR_A12: U7.42, U8.91, U9.36
/SDR_BA0: U7.26, U8.54, U9.20
/SDR_BA1: U7.27, U8.52, U9.21
/SDR_CAS: U7.22, U8.57, U9.17
/SDR_CKE: U7.44, U8.90, U9.37
/SDR_CLK: U7.45, U8.89, U9.38
/SDR_CS: U7.24, U8.55, U9.19
/SDR_DQ0: U7.2, U8.59, U9.2
/SDR_DQ1: U7.4, U8.60, U9.4
/SDR_DQ2: U7.5, U8.61, U9.5
/SDR_DQ3: U7.7, U8.62, U9.7
/SDR_DQ4: U7.8, U8.64, U9.8
/SDR_DQ5: U7.10, U8.65, U9.10
/SDR_DQ6: U7.11, U8.66, U9.11
/SDR_DQ7: U7.13, U8.69, U9.13
/SDR_DQ8: U7.54, U8.84, U9.42
/SDR_DQ9: U7.56, U8.81, U9.44
/SDR_DQ10: U7.57, U8.80, U9.45
/SDR_DQ11: U7.59, U8.79, U9.47
/SDR_DQ12: U7.60, U8.78, U9.48
/SDR_DQ13: U7.62, U8.77, U9.50
/SDR_DQ14: U7.63, U8.76, U9.51
/SDR_DQ15: U7.65, U8.75, U9.53
/SDR_DQMH: U7.47, U8.86, U9.39
/SDR_DQML: U7.20, U8.74, U9.15
/SDR_RAS: U7.23, U8.56, U9.18
/SDR_WE: U7.21, U8.58, U9.16
/SSEL: CN1.B3, U11.2
/SSEL_3V: U8.101, U11.47
/USB_VBUS: C9.1, CON1.1, D1.1
/VCC_SDRAM: C25.1, C28.1, C32.1, C33.1, C34.1, C40.1, C43.1, C45.1, C48.1, C49.1, C51.1, R5.1, R10.2, U6.2, U7.1, U7.3, U7.9, U7.15, U7.18, U7.33, U7.55, U7.61, U8.40, U8.49, U8.67, U8.82, U8.94, U8.103, U9.1, U9.3, U9.9, U9.14, U9.27, U9.43, U9.49, U11.1, U11.31, U11.42
/WAIT_ENABLE: U3.25, U8.44
GND: A1.2, C1.2, C2.2, C3.2, C4.2, C5.2, C6.2, C7.2, C8.2, C9.2, C10.2, C11.2, C12.2, C13.2, C14.2, C15.2, C16.2, C17.2, C18.2, C19.2, C20.2, C21.2, C22.2, C23.2, C24.2, C25.2, C26.2, C27.2, C28.2, C29.2, C30.2, C31.2, C32.2, C33.2, C34.2, C35.2, C36.2, C37.2, C38.2, C39.2, C40.2, C41.2, C42.2, C43.2, C44.2, C45.2, C46.2, C47.2, C48.2, C49.2, C50.2, C51.2, C52.2, C53.2, C54.2, C55.2, CN1.A8, CN1.A13, CN1.A18, CN1.A23, CN1.A29, CN1.A36, CN1.A41, CN1.A46, CN1.A54, CN1.A59, CN1.A64, CN1.A65, CN1.B7, CN1.B8, CN1.B13, CN1.B18, CN1.B23, CN1.B29, CN1.B36, CN1.B41, CN1.B46, CN1.B54, CN1.B59, CN1.B64, CN1.B65, CON1.5, CON1.6, CON2.3, CON2.6, CON2.12, CON2.13, CON3.2, CON3.10, CON4.6, CON5.6, R9.1, R11.1, R15.2, R18.1, U1.4, U1.10, U1.15, U1.21, U1.24, U1.28, U1.34, U1.39, U1.45, U2.1, U2.4, U2.10, U2.15, U2.19, U2.20, U2.21, U2.22, U2.23, U2.24, U2.25, U2.28, U2.34, U2.39, U2.45, U2.48, U3.1, U3.4, U3.10, U3.11, U3.12, U3.15, U3.21, U3.26, U3.27, U3.28, U3.29, U3.30, U3.32, U3.33, U3.34, U3.39, U3.45, U3.48, U4.1, U4.4, U4.10, U4.15, U4.21, U4.28, U4.34, U4.39, U4.45, U5.1, U6.1, U7.6, U7.12, U7.34, U7.48, U7.52, U7.58, U7.64, U7.66, U8.3, U8.4, U8.42, U8.53, U8.63, U8.68, U8.83, U8.95, U8.104, U8.116, U8.125, U8.133, U8.137, U8.142, U8.145, U9.6, U9.12, U9.28, U9.41, U9.46, U9.52, U9.54, U10.8, U10.23, U10.35, U10.47, U11.4, U11.9, U11.10, U11.15, U11.21, U11.24, U11.25, U11.28, U11.34, U11.39, U11.45, U11.48, U12.9, U12.11, U12.13, U12.55, U12.57
unnamed: A1.1, U12.12
unnamed: C10.1, CON1.3, R1.2
unnamed: C11.1, CON1.2, R2.2
unnamed: C14.1, C15.1, D1.3, U5.3
unnamed: C26.1, U12.16, Y1.1
unnamed: C27.1, U12.17, Y1.2
unnamed: C52.1, U12.45
unnamed: C53.1, U12.56
unnamed: CON2.1, R4.2, U8.25
unnamed: CON2.2, R6.2, U8.26
unnamed: CON2.5, U8.22
unnamed: CON2.7, R7.2, U8.24
unnamed: CON2.8, R8.2
unnamed: CON2.9, R3.2
unnamed: CON4.1, U10.34
unnamed: CON4.3, U10.37
unnamed: CON5.1, U12.26
unnamed: CON5.3, R18.2, U12.27
unnamed: JP1.2, R9.2, U10.44
unnamed: R1.1, U10.33
unnamed: R2.1, U10.32
unnamed: R10.1, R11.2, U7.49
unnamed: U12.2, Y2.1
unnamed: U12.3, Y2.2
