cafe-alpha/wascafe/v10/board/wasca.kicad_pcb

## KiCad design v10/board/wasca.kicad_pcb (2016-08-04, an earlier design)

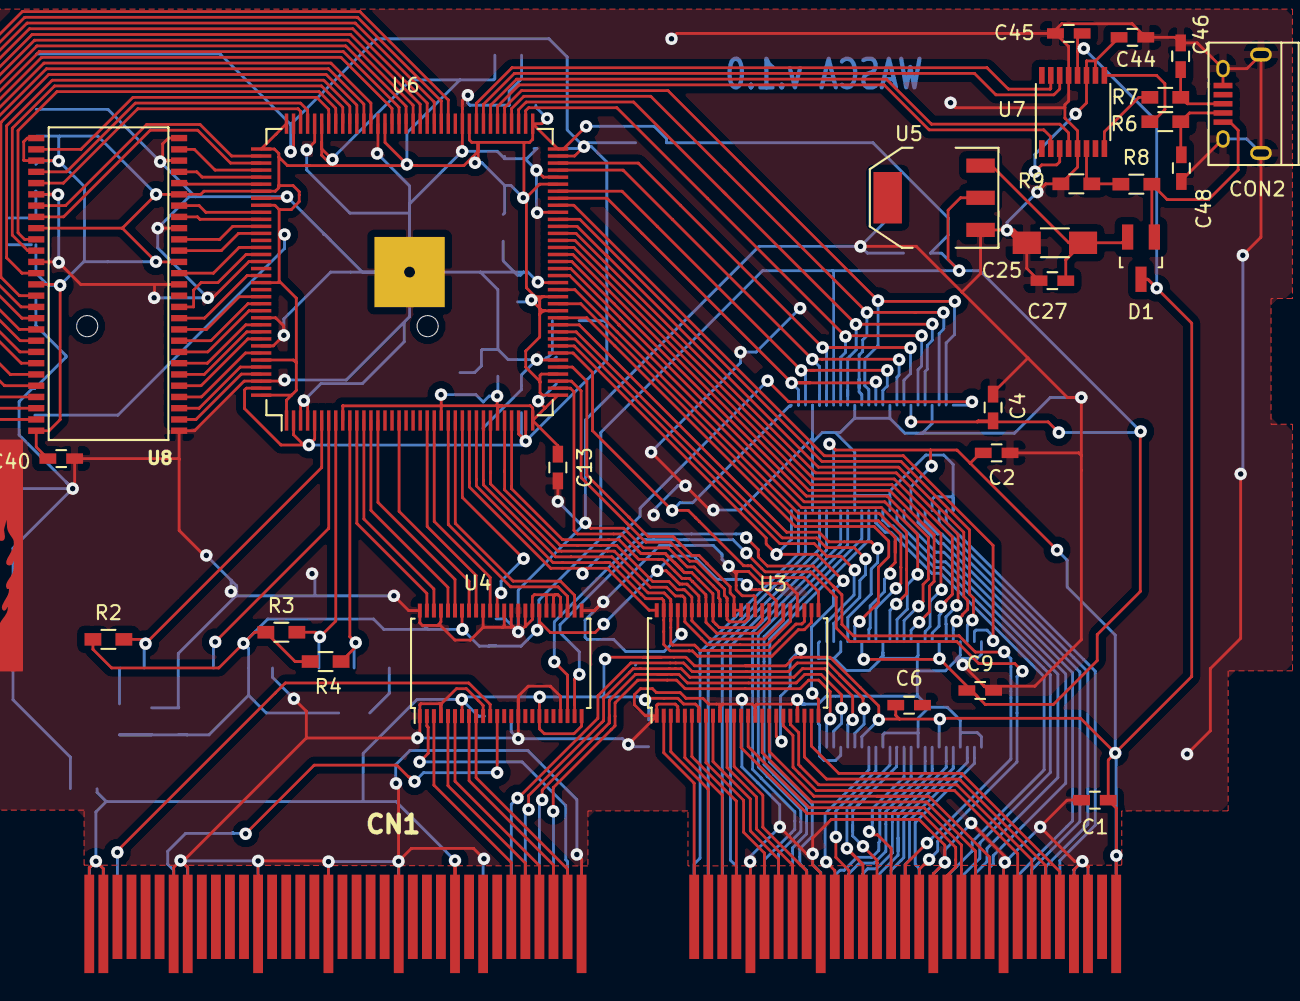
[picture p22: board v10/board/wasca.kicad_pcb from above]

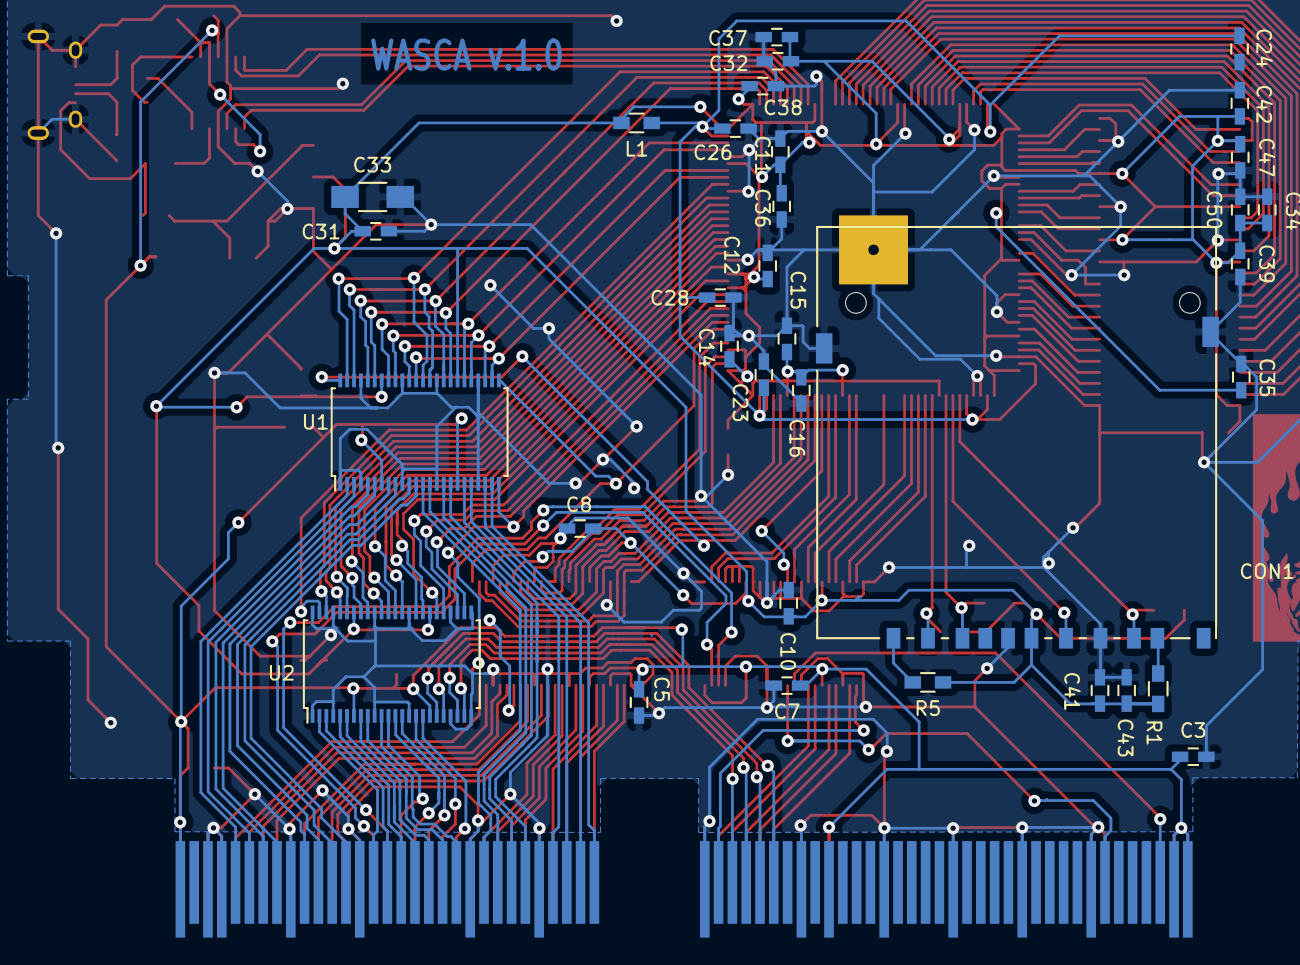
[picture p23: board v10/board/wasca.kicad_pcb from below]

Board: 2 copper layers, 64 parts (34 on the bottom side), 164 nets.

Parts:
C1: 10uF; C_0603_HandSoldering
C2, C3, C4, C5, C6, C7, C8, C9, C10, C11, C12, C13, C14, C15, C16, C23, C24, C26, C27, C28, C31, C32, C34, C35, C36, C37, C38, C39, C40, C41, C42, C44, C45, C46, C47, C48, C50: 0.1uF; C_0603_HandSoldering
C25, C33: 10uF; C_1206_HandSoldering
C43: 1uF; C_0603_HandSoldering
CN1: CARTRIDGE_EDGE_CONNECTOR; CARTRIDGE_EDGE_CONNECTOR2
CON1: SD_Card; SD_Card_Receptacle
CON2: USB_OTG; USB_Micro-B
CON3: Thermal_Quad; Termal_Quad
D1: D_Schottky_x2_KCom; SOT-23_Handsoldering
L1: L_Small; R_0603_HandSoldering
R1, R2, R3, R4, R5: 50K; R_0603_HandSoldering
R6, R7: 27; R_0603_HandSoldering
R8, R9: 4.7K; R_0603_HandSoldering
U1, U2, U3, U4: 74ALVC164245; TSSOP-48_6.1x12.5mm_Pitch0.5mm
U5: LD1117S33CTR; SOT-223
U6: 10M04SFE144C8G; TQFP-144_20x20mm_Pitch0.5mm
U7: FT201XS; SSOP-16_3.9x4.9mm_Pitch0.635mm
U8: MT48LC32M16A2TG; TSOP_II_54

Connections:
/+3_3V: C4.1, C8.1, C9.1, C10.1, C11.1, C12.1, C13.1, C14.1, C15.1, C16.1, C31.1, C32.1, C33.1, C34.1, C35.1, C36.1, C37.1, C38.1, C39.1, C40.1, C41.1, C42.1, C43.1, C47.1, C50.1, CON1.4, L1.2, R1.1, R2.1, R3.1, R4.1, R5.1, U1.31, U1.42, U2.31, U2.42, U3.31, U3.42, U4.31, U4.42, U5.2, U6.1, U6.9, U6.23, U6.31, U6.36, U6.37, U6.40, U6.49, U6.51, U6.67, U6.72, U6.73, U6.82, U6.94, U6.103, U6.108, U6.109, U6.115, U6.117, U6.128, U6.139, U6.144, U8.1, U8.3, U8.9, U8.14, U8.27, U8.43, U8.49
/+5V: C1.1, C2.1, C3.1, C5.1, C6.1, C7.1, C45.1, CN1.A1, CN1.A2, CN1.A27, CN1.A67, CN1.B1, CN1.B2, CN1.B27, CN1.B67, D1.3, U1.7, U1.18, U2.7, U2.18, U3.7, U3.18, U4.7, U4.18, U4.24, U7.12
/ABUS_3V_A16: U4.40, U6.21
/ABUS_3V_A17: U4.47, U6.11
/ABUS_3V_A18: U4.41, U6.17
/ABUS_3V_A19: U2.26, U6.45
/ABUS_3V_A20: U4.43, U6.14
/ABUS_3V_A21: U2.27, U6.46
/ABUS_3V_A22: U4.44, U6.13
/ABUS_3V_A23: U2.29, U6.47
/ABUS_3V_A24: U4.46, U6.12
/ABUS_3V_A25: U2.30, U6.48
/ABUS_3V_AS: U2.47, U6.64
/ABUS_3V_CS0: U2.38, U6.57
/ABUS_3V_CS1: U2.33, U6.52
/ABUS_3V_CS2: U2.40, U6.58
/ABUS_3V_FC0: U2.43, U6.60
/ABUS_3V_FC1: U2.36, U6.55
/ABUS_3V_IRQ: U4.26, U6.25
/ABUS_3V_MUX0: U3.26, U3.47, U6.28
/ABUS_3V_MUX1: U3.27, U3.46, U6.29
/ABUS_3V_MUX2: U3.29, U3.44, U6.30
/ABUS_3V_MUX3: U3.30, U3.43, U6.32
/ABUS_3V_MUX4: U3.32, U3.41, U6.33
/ABUS_3V_MUX5: U3.33, U3.40, U6.38
/ABUS_3V_MUX6: U3.35, U3.38, U6.39
/ABUS_3V_MUX7: U3.36, U3.37, U6.41
/ABUS_3V_MUX8: U1.36, U1.47, U6.77
/ABUS_3V_MUX9: U1.35, U1.46, U6.76
/ABUS_3V_MUX10: U1.33, U1.44, U6.75
/ABUS_3V_MUX11: U1.32, U1.43, U6.74
/ABUS_3V_MUX12: U1.30, U1.41, U6.70
/ABUS_3V_MUX13: U1.29, U1.40, U6.69
/ABUS_3V_MUX14: U1.27, U1.38, U6.66
/ABUS_3V_MUX15: U1.26, U1.37, U6.65
/ABUS_3V_MUX_DATA_DIR: U1.24, U3.24, U6.44
/ABUS_3V_MUX_EN1: U1.48, U3.48, U6.27
/ABUS_3V_MUX_EN2: U1.25, U3.25, U6.43
/ABUS_3V_RD: U2.32, U6.50
/ABUS_3V_TIM0: U2.44, U6.61
/ABUS_3V_TIM1: U2.37, U6.56
/ABUS_3V_TIM2: U2.46, U6.62
/ABUS_3V_WAIT: U4.27, U6.24
/ABUS_3V_WR0: U2.41, U6.59
/ABUS_3V_WR1: U2.35, U6.54
/ABUS_A0: CN1.B45, U3.12
/ABUS_A1: CN1.A45, U1.13
/ABUS_A2: CN1.B44, U3.11
/ABUS_A3: CN1.B43, U3.9
/ABUS_A4: CN1.B42, U3.8
/ABUS_A5: CN1.B40, U3.6
/ABUS_A6: CN1.B39, U3.5
/ABUS_A7: CN1.B38, U3.3
/ABUS_A8: CN1.A40, U1.19
/ABUS_A9: CN1.A42, U1.17
/ABUS_A10: CN1.A44, U1.14
/ABUS_A11: CN1.A43, U1.16
/ABUS_A12: CN1.A38, U1.22
/ABUS_A13: CN1.A39, U1.20
/ABUS_A14: CN1.B37, U3.2
/ABUS_A15: CN1.A37, U1.23
/ABUS_A16: CN1.B35, U4.9
/ABUS_A17: CN1.A35, U4.2
/ABUS_A18: CN1.B34, U4.8
/ABUS_A19: CN1.A34, U2.23
/ABUS_A20: CN1.B33, U4.6
/ABUS_A21: CN1.A33, U2.22
/ABUS_A22: CN1.B32, U4.5
/ABUS_A23: CN1.A32, U2.20
/ABUS_A24: CN1.B31, U4.3
/ABUS_A25: CN1.A31, U2.19
/ABUS_AS: CN1.A53, U2.2
/ABUS_CS0: CN1.A47, U2.11
/ABUS_CS1: CN1.B48, U2.16
/ABUS_CS2: CN1.A48, U2.9
/ABUS_D0: CN1.A55, U1.12
/ABUS_D1: CN1.A56, U1.11
/ABUS_D2: CN1.A57, U1.9
/ABUS_D3: CN1.A58, U1.8
/ABUS_D4: CN1.B58, U3.17
/ABUS_D5: CN1.B57, U3.16
/ABUS_D6: CN1.B56, U3.14
/ABUS_D7: CN1.B55, U3.13
/ABUS_D8: CN1.A60, U1.6
/ABUS_D9: CN1.A61, U1.5
/ABUS_D10: CN1.A62, U1.3
/ABUS_D11: CN1.A63, U1.2
/ABUS_D12: CN1.B63, U3.23
/ABUS_D13: CN1.B62, U3.22
/ABUS_D14: CN1.B61, U3.20
/ABUS_D15: CN1.B60, U3.19
/ABUS_FC0: CN1.A50, U2.6
/ABUS_FC1: CN1.B50, U2.13
/ABUS_IRQ: CN1.B53, U4.23
/ABUS_RD: CN1.B47, U2.17
/ABUS_TIM0: CN1.A51, U2.5
/ABUS_TIM1: CN1.B51, U2.12
/ABUS_TIM2: CN1.A52, U2.3
/ABUS_WAIT: CN1.B52, U4.22
/ABUS_WR0: CN1.A49, U2.8
/ABUS_WR1: CN1.B49, U2.14
/RESET: CN1.A3, U4.11
/RESET_3V: U4.38, U6.22
/SCSPCLK: CN1.A7, U4.12
/SCSPCLK_3V: U4.37, U6.26
/SDR_A0: U6.88, U8.23
/SDR_A1: U6.87, U8.24
/SDR_A2: U6.86, U8.25
/SDR_A3: U6.85, U8.26
/SDR_A4: U6.141, U8.29
/SDR_A5: U6.140, U8.30
/SDR_A6: U6.138, U8.31
/SDR_A7: U6.136, U8.32
/SDR_A8: U6.135, U8.33
/SDR_A9: U6.134, U8.34
/SDR_A10: U6.89, U8.22
/SDR_A11: U6.132, U8.35
/SDR_A12: U6.131, U8.36
/SDR_BA0: U6.91, U8.20
/SDR_BA1: U6.90, U8.21
/SDR_CAS: U6.96, U8.17
/SDR_CKE: U6.130, U8.37
/SDR_CLK: U6.127, U8.38
/SDR_CS: U6.92, U8.19
/SDR_DQ0: U6.102, U8.2
/SDR_DQ1: U6.105, U8.4
/SDR_DQ2: U6.106, U8.5
/SDR_DQ3: U6.110, U8.7
/SDR_DQ4: U6.111, U8.8
/SDR_DQ5: U6.101, U8.10
/SDR_DQ6: U6.100, U8.11
/SDR_DQ7: U6.99, U8.13
/SDR_DQ8: U6.123, U8.42
/SDR_DQ9: U6.121, U8.44
/SDR_DQ10: U6.120, U8.45
/SDR_DQ11: U6.119, U8.47
/SDR_DQ12: U6.118, U8.48
/SDR_DQ13: U6.114, U8.50
/SDR_DQ14: U6.113, U8.51
/SDR_DQ15: U6.112, U8.53
/SDR_DQMH: U6.124, U8.39
/SDR_DQML: U6.98, U8.15
/SDR_RAS: U6.93, U8.18
/SDR_WE: U6.97, U8.16
/USB_CBUS0: U6.81, U7.15
/USB_CBUS1: U6.80, U7.14
/USB_SCL: U6.78, U7.2
/USB_SDA: U6.79, U7.4
/USB_VBUS: CON2.1, D1.1, R8.2
GND: C1.2, C2.2, C3.2, C4.2, C5.2, C6.2, C7.2, C8.2, C9.2, C10.2, C11.2, C12.2, C13.2, C14.2, C15.2, C16.2, C23.2, C24.2, C25.2, C26.2, C27.2, C28.2, C31.2, C32.2, C33.2, C34.2, C35.2, C36.2, C37.2, C38.2, C39.2, C40.2, C41.2, C42.2, C43.2, C44.2, C45.2, C46.2, C47.2, C48.2, C50.2, CN1.A8, CN1.A13, CN1.A18, CN1.A23, CN1.A29, CN1.A36, CN1.A41, CN1.A46, CN1.A54, CN1.A59, CN1.A64, CN1.A65, CN1.B7, CN1.B8, CN1.B13, CN1.B18, CN1.B23, CN1.B29, CN1.B36, CN1.B41, CN1.B46, CN1.B54, CN1.B59, CN1.B64, CN1.B65, CON1.3, CON1.6, CON1.12, CON1.13, CON2.5, CON2.6, CON3.1, R9.1, U1.1, U1.4, U1.10, U1.15, U1.21, U1.28, U1.34, U1.39, U1.45, U2.1, U2.4, U2.10, U2.15, U2.21, U2.24, U2.25, U2.28, U2.34, U2.39, U2.45, U2.48, U3.1, U3.4, U3.10, U3.15, U3.21, U3.28, U3.34, U3.39, U3.45, U4.1, U4.4, U4.10, U4.15, U4.21, U4.25, U4.28, U4.29, U4.30, U4.32, U4.33, U4.34, U4.35, U4.36, U4.39, U4.45, U4.48, U5.1, U6.3, U6.4, U6.42, U6.53, U6.63, U6.68, U6.83, U6.95, U6.104, U6.116, U6.125, U6.133, U6.137, U6.142, U7.5, U7.13, U8.6, U8.12, U8.28, U8.41, U8.46, U8.52, U8.54
unnamed: C23.1, C24.1, C26.1, C28.1, L1.1, U6.2, U6.5, U6.34, U6.35, U6.71, U6.107, U6.143
unnamed: C25.1, C27.1, D1.2, U5.3
unnamed: C44.1, U7.3, U7.10, U7.11
unnamed: C46.1, CON2.3, R7.1
unnamed: C48.1, CON2.2, R6.1
unnamed: CON1.1, R4.2, U6.10
unnamed: CON1.2, R3.2, U6.8
unnamed: CON1.5, U6.7
unnamed: CON1.7, R2.2, U6.6
unnamed: CON1.8, R1.2
unnamed: CON1.9, R5.2
unnamed: R6.2, U7.9
unnamed: R7.2, U7.8
unnamed: R8.1, R9.2, U7.6
