cafe-alpha/wascafe/v12/board/usbcart/usbcart.kicad_pcb

## KiCad design v12/board/usbcart/usbcart.kicad_pcb (2016-07-11, an earlier design)

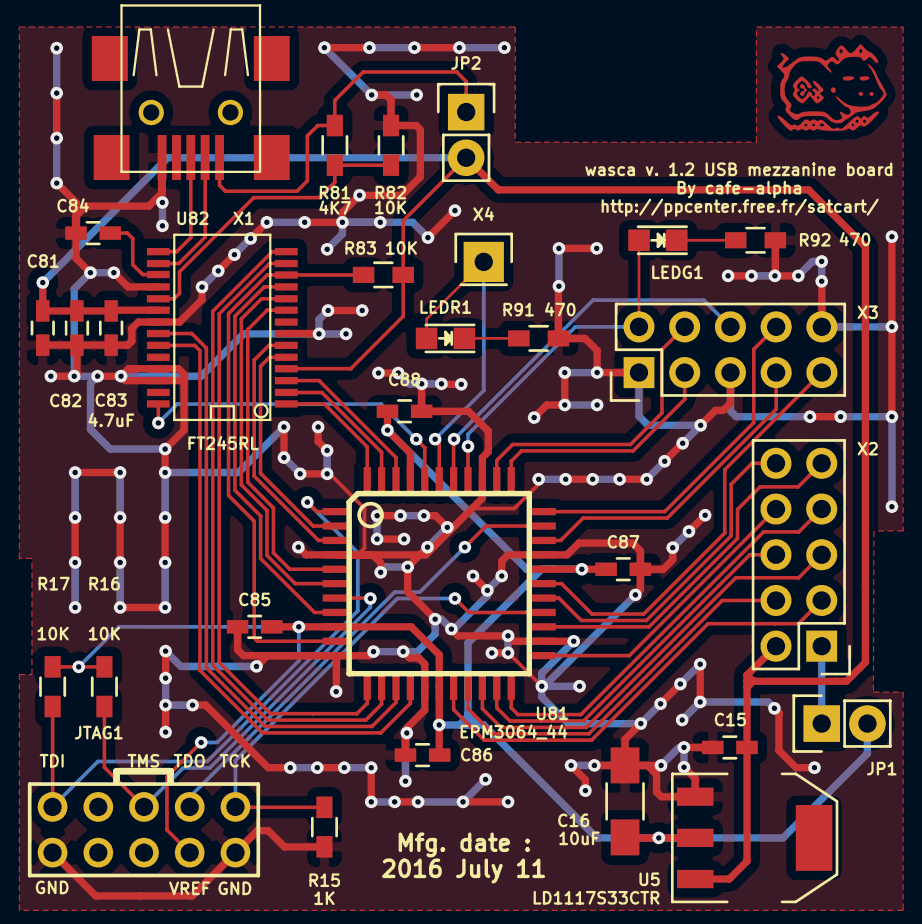
[picture p24: board usbcart.kicad_pcb from above]

Board: 2 copper layers, 30 parts (0 on the bottom side), 45 nets.

Parts:
C15, C81, C82, C84, C85, C86, C87, C88: 0.1uF; C_0603_HandSoldering
C16: 10uF; C_1206_HandSoldering
C83: 4.7uF; C_0603_HandSoldering
JP1, JP2: JUMPER; Pin_Header_Straight_1x02
JTAG1: AVR-JTAG-10; JTAG_Header
LEDG1: LED; LED_0805
LEDR1: LED; LED_0805
R15: 1K; R_0603_HandSoldering
R16, R17, R82, R83: 10K; R_0603_HandSoldering
R81: 4K7; R_0603_HandSoldering
R91, R92: 470; R_0603_HandSoldering
U5: LD1117S33CTR; SOT-223
U81: EPM3064_44; TQFP44
U82: FT245RL; SSOP28
X1: USB-MB-S; con-usb-USB-MB-S
X2, X3: CONN_02X05; Pin_Header_Straight_2x05
X4: CONN_01X01; Pin_Header_Straight_1x01

Connections:
/+3_3V: C16.1, C85.1, C86.1, C87.1, C88.1, JP1.2, JTAG1.4, R16.1, R17.1, U5.2, U81.9, U81.17, U81.29, U81.41
/+3_3V_BOARD: JP1.1, X2.1
/+5V: C15.1, C81.1, C82.1, C83.1, JP2.2, R83.1, U5.3, U82.4, U82.20, X2.2
/ABUS_A0: U81.31, X3.7
/ABUS_A1: U81.22, X2.7
/ABUS_A2: U81.33, X3.8
/ABUS_D0: U81.21, X2.6
/ABUS_D1: U81.20, X2.5
/ABUS_D2: U81.19, X2.4
/ABUS_D3: U81.18, X2.3
/ABUS_D4: U81.23, X2.8
/ABUS_D5: U81.25, X2.9
/ABUS_D6: U81.27, X2.10
/ABUS_D7: U81.28, X3.9
/EPM_SPARE: LEDR1.2, U81.39, X4.1
/FTDI_D0: U81.44, U82.1
/FTDI_D1: U81.2, U82.5
/FTDI_D2: U81.42, U82.3
/FTDI_D3: U81.8, U82.11
/FTDI_D4: U81.43, U82.2
/FTDI_D5: U81.5, U82.9
/FTDI_D6: U81.6, U82.10
/FTDI_D7: U81.3, U82.6
/FTDI_OSCO: U81.40, U82.28
/FTDI_PWREN: R83.2, U81.10, U82.12
/FTDI_RD: U81.12, U82.13
/FTDI_RXF: U81.15, U82.23
/FTDI_TXE: U81.14, U82.22
/FTDI_WR: U81.13, U82.14
/JTAG_TCK: JTAG1.1, R15.1, U81.26
/JTAG_TDI: JTAG1.9, R17.2, U81.1
/JTAG_TDO: JTAG1.3, U81.32
/JTAG_TMS: JTAG1.5, R16.2, U81.7
/USB_CS: U81.34, X3.3
/USB_RD: U81.35, X3.4
/USB_SPARE1: U81.38, X3.6
/USB_SPARE2: LEDG1.2, U81.37, X3.2
GND: C15.2, C16.2, C81.2, C82.2, C83.2, C84.2, C85.2, C86.2, C87.2, C88.2, JTAG1.2, JTAG1.10, R15.2, R82.1, R91.1, R92.1, U5.1, U81.4, U81.11, U81.16, U81.24, U81.30, U81.36, U82.7, U82.18, U82.21, U82.25, U82.26, X1.GND, X3.1, X3.5, X3.10
unnamed: C84.1, U82.17
unnamed: JP2.1, R81.2, X1.VBUS
unnamed: LEDG1.1, R92.2
unnamed: LEDR1.1, R91.2
unnamed: R81.1, R82.2, U82.19
unnamed: U82.15, X1.D+
unnamed: U82.16, X1.D-
