cafe-alpha/wascafe/v13/r07c_firm_F446RE_20201025/Src/main.c

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
/* Includes ------------------------------------------------------------------*/
#include "main.h"
#include "fatfs.h"

/* USER CODE BEGIN Includes */

#include <fatfs.h>

#include <string.h>
#include "bup_bootrom.h"
#include "spi_max10.h"
#include "log.h"
#include "misc_tests.h"

/* USER CODE END Includes */

CRC_HandleTypeDef hcrc;

SD_HandleTypeDef hsd;

SPI_HandleTypeDef hspi2;
DMA_HandleTypeDef hdma_spi2_rx;
DMA_HandleTypeDef hdma_spi2_tx;

UART_HandleTypeDef huart2;

/* USER CODE BEGIN PV */

/* File system object for SD card logical drive */
FATFS SDFatFs;

/* USER CODE END PV */

void SystemClock_Config(void);
static void MX_GPIO_Init(void);
static void MX_DMA_Init(void);
static void MX_USART2_UART_Init(void);
static void MX_SPI2_Init(void);
static void MX_SDIO_SD_Init(void);
static void MX_CRC_Init(void);
/* USER CODE BEGIN PFP */

/* USER CODE END PFP */

/* USER CODE BEGIN 0 */

// Redirect printf to UART
// Related information : http://www.openstm32.org/forumthread1346
int __io_putchar(int ch)
{
    HAL_UART_Transmit(&huart2, (uint8_t *)&ch, 1, 0xFFFF);

    return ch;
}
int _write(int file, char *ptr, int len)
{
    int DataIdx;

    for (DataIdx = 0; DataIdx < len; DataIdx++)
    {
        __io_putchar(*ptr++);
    }
    return len;
}

/* USER CODE END 0 */

/**
  * @brief  The application entry point.
  * @retval int
  */
int main(void)
{
  /* MCU Configuration--------------------------------------------------------*/

  /* Reset of all peripherals, Initializes the Flash interface and the Systick. */
  HAL_Init();

  /* USER CODE BEGIN Init */
  log_init();
  /* USER CODE END Init */

  /* Configure the system clock */
  SystemClock_Config();

  /* Initialize all configured peripherals */
  MX_GPIO_Init();
  MX_DMA_Init();
  MX_USART2_UART_Init();
  MX_SPI2_Init();
  MX_SDIO_SD_Init();
  MX_FATFS_Init();
  MX_CRC_Init();
  /* USER CODE BEGIN 2 */

  /* Output a message on Hyperterminal using printf function */
  termout(WL_LOG_DEBUGNORMAL, "UART Printf Example: retarget the C library printf function to the UART");
  termout(WL_LOG_DEBUGNORMAL, "Build Date : %s, time : %s, for Nucleo F446RE.", __DATE__, __TIME__);


  /* Initialize SD card and FatFs. */
  termout(WL_LOG_DEBUGNORMAL, "retSD:%d SDPath:%c%c%c%c", retSD, SDPath[0], SDPath[1], SDPath[2], SDPath[3]);
  termout(WL_LOG_DEBUGNORMAL, "BSP_SD_IsDetected:%d", BSP_SD_IsDetected());
  if(retSD == 0)
  {
    /* success: set the orange LED on */
    // HAL_GPIO_WritePin(GPIOG, GPIO_PIN_7, GPIO_PIN_RESET);

    /*##-2- Register the file system object to the FatFs module ###*/
    termout(WL_LOG_DEBUGNORMAL, "FatFs Initialization STT ...");
    if(f_mount(&SDFatFs, (TCHAR const*)SDPath, 0) != FR_OK)
    {
        /* FatFs Initialization Error : set the red LED on */
        termout(WL_LOG_DEBUGNORMAL, "FatFs Initialization Error !");
        //HAL_GPIO_WritePin(GPIOG, GPIO_PIN_10, GPIO_PIN_RESET);
        //while(1);
    }
  }


#if 0
while(1) // TEST : see how good or bad SPI synchronization status is read from MAX10
{
//#define SPI_MAX10_RCV_HDR_READY() HAL_GPIO_WritePin(GPIOA, SPI_SYNC_Pin, GPIO_PIN_RESET)
//#define SPI_MAX10_SND_RSP_READY() HAL_GPIO_WritePin(GPIOA, SPI_SYNC_Pin, GPIO_PIN_SET  )
    int stateOfPushButton = HAL_GPIO_ReadPin(B1_GPIO_Port, B1_Pin);
    if(stateOfPushButton == GPIO_PIN_RESET)
    {
        HAL_GPIO_WritePin(SPI_SYNC_Port, SPI_SYNC_Pin, GPIO_PIN_RESET);
        HAL_GPIO_WritePin(LD2_GPIO_Port, LD2_Pin, GPIO_PIN_RESET);
    }
    else
    {
        HAL_GPIO_WritePin(SPI_SYNC_Port, SPI_SYNC_Pin, GPIO_PIN_SET  );
        HAL_GPIO_WritePin(LD2_GPIO_Port, LD2_Pin, GPIO_PIN_SET);
    }
}
#endif

  logout(WL_LOG_DEBUGNORMAL, "---");
  logout(WL_LOG_DEBUGNORMAL, "UART Printf Example: retarget the C library printf function to the UART");
  logout(WL_LOG_DEBUGNORMAL, "Build Date : %s, time : %s, for Nucleo F446RE.", __DATE__, __TIME__);

  /* Initialize SPI internals. */
  spi_init();

  /* Update backup and boot ROM access modules. */
  bup_init();
  bootrom_init();

  /* USER CODE END 2 */

  /* Infinite loop */
  /* USER CODE BEGIN WHILE */
  unsigned long logmsg_id = 0;

  /* Count the number of packets received between two time intervals. */
  unsigned long spi_init_cnt = 0;
  unsigned long prev_spi_init_cnt = spi_init_cnt;
  unsigned long prev_spi_init_tickcnt = HAL_GetTick();

  unsigned long prev_tick = HAL_GetTick();
  while (1)
  {
    wl_spi_pkt_t* trans_hdr = &_spi_trans_hdr;

    /* Display SPI communication status. */
    log_infos_t* log_info = &_log_inf_data;

    /* Compute the number of packets exchanged in one second. */
    unsigned long spi_init_tickcnt = HAL_GetTick();
    unsigned long spi_tick_delta = spi_init_tickcnt - prev_spi_init_tickcnt;
    if(spi_tick_delta > 5)
    {
        unsigned long spi_packet_cnt = spi_init_cnt - prev_spi_init_cnt;
        unsigned long spi_packet_rate = (1000 * spi_packet_cnt) / spi_tick_delta;

        /* Also indicate transfer speed in KB/s unit.
         * Note : as same data size is sent in both directions between
         *        MAX 10 and STM32, speed is indicated as "theoretical"
         *        maximum speed that would be reached with proper transmission
         *        protocol which (for example) would feature larger packet
         *        size from the device transferring the larger amount of data.
         */
        unsigned long spi_speed_kbps = spi_packet_rate * (sizeof(wl_spi_pkt_t) * 2);
        spi_speed_kbps = spi_speed_kbps / 1024;

        char data_log[32+1];
        memcpy(data_log, trans_hdr->data, sizeof(data_log)-1); data_log[sizeof(data_log)-1] = '\0';
unsigned char char2pchar(unsigned char c);
        for(int i=0; i<(sizeof(data_log)-1); i++)
        {
            data_log[i] = char2pchar(data_log[i]);
        }

        logout(WL_LOG_DEBUGNORMAL, "[%08X:%d] ID[%2u] PKT/s[%4u][%4u KB/s] Tot[%5u]S[%5u] [%s] [cbu:%5u] R:%04X W:%04X"
            , (unsigned int)HAL_GetTick()
            , _spi_state
            , (unsigned int)logmsg_id
            , (unsigned int)spi_packet_rate
            , (unsigned int)spi_speed_kbps
            , (unsigned int)_spi_rcv_cnt
            , (unsigned int)_spi_shift_cnt
            //, trans_hdr->cmn.magic_ca , trans_hdr->cmn.magic_fe // PKT[%02X %02X]
            , data_log
            , (unsigned int)log_cbmem_use()
            , log_info->readptr, log_info->writeptr
            );

        logmsg_id = (logmsg_id+1) % 100;
    }

    prev_spi_init_cnt = spi_init_cnt;
    prev_spi_init_tickcnt = spi_init_tickcnt;

    //int i;
    while(1)
    {
        // // STM32 SPI synchronization test (I/O test only) vvv
        // int stateOfPushButton = HAL_GPIO_ReadPin(B1_GPIO_Port, B1_Pin);
        // logout(WL_LOG_DEBUGNORMAL, "    [0x%08X][%s::%d] SYNC:%d", (unsigned int)HAL_GetTick(), __FILE__, __LINE__, stateOfPushButton);
        // HAL_GPIO_WritePin(SPI_SYNC_Port, SPI_SYNC_Pin, (stateOfPushButton ? GPIO_PIN_SET : GPIO_PIN_RESET));
        // // STM32 SPI synchronization test (I/O test only) ^^^

        //HAL_Delay(50);

        /* Send log message at a reasonable rate when blue button is released,
         * and like crazy when it is pushed.
         */
        unsigned long log_period = (HAL_GPIO_ReadPin(B1_GPIO_Port, B1_Pin) == GPIO_PIN_RESET ? 10 : 500);
        if((HAL_GetTick() - prev_tick) > log_period)
        {
            break;
        }


        /* If packet received from MAX 10,
         * then process its answer.
         */
        if(spi_periodic_check() == 1)
        {
            spi_init_cnt++;
        }

        /* Update backup data intenals. */
        bup_periodic_check();

        /* Do miscellaneous tests. */
        do_tests();
    }

    prev_tick = HAL_GetTick();

    /* USER CODE END WHILE */

    /* USER CODE BEGIN 3 */

  }

  /* Terminate FatFs (never called). */
  termout(WL_LOG_DEBUGNORMAL, "FATFS_UnLinkDriver ...");
  FATFS_UnLinkDriver(SDPath);

  /* USER CODE END 3 */
}

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
