cafe-alpha/wascafe/v13/r07c_de10_20201014_abus4/wasca_toplevel.vhd

-- wasca.vhd

-- Generated using ACDS version 14.1 186 at 2015.05.28.08:37:08

library IEEE;
use IEEE.std_logic_1164.all;
use IEEE.numeric_std.all;

entity wasca_toplevel is
	port (
		clk_clk                                     : in    std_logic                     := '0';             --                            clk.clk

		external_sdram_controller_wire_addr         : out   std_logic_vector(12 downto 0);                    -- external_sdram_controller_wire.addr
		external_sdram_controller_wire_ba           : out   std_logic_vector(1 downto 0);                                        --                               .ba
		external_sdram_controller_wire_cas_n        : out   std_logic;                                        --                               .cas_n
		external_sdram_controller_wire_cke          : out   std_logic;                                        --                               .cke
		external_sdram_controller_wire_cs_n         : out   std_logic;                                        --                               .cs_n
		external_sdram_controller_wire_dq           : inout std_logic_vector(15 downto 0) := (others => '0'); --                               .dq
		external_sdram_controller_wire_dqm          : out   std_logic_vector(1 downto 0);                     --                               .dqm
		external_sdram_controller_wire_ras_n        : out   std_logic;                                        --                               .ras_n
		external_sdram_controller_wire_we_n         : out   std_logic;                                        --                               .we_n
		external_sdram_controller_wire_clk          : out   std_logic;                                        --                               .clk
		reset_reset_n                               : in    std_logic                     := '0';             --                          reset.reset_n
		sega_saturn_abus_slave_0_abus_address       : in    std_logic_vector(25 downto 16) := (others => '0'); --  sega_saturn_abus_slave_0_abus.address
		sega_saturn_abus_slave_0_abus_addressdata   : inout std_logic_vector(15 downto 0) := (others => '0'); --                               .data
		sega_saturn_abus_slave_0_abus_chipselect    : in    std_logic_vector(2 downto 0)  := (others => '0'); --                               .chipselect
		sega_saturn_abus_slave_0_abus_read          : in    std_logic                     := '0';             --                               .read
		sega_saturn_abus_slave_0_abus_write         : in    std_logic_vector(1 downto 0)  := (others => '0'); --                               .write
		sega_saturn_abus_slave_0_abus_waitrequest   : out   std_logic;                                        --                               .waitrequest
		sega_saturn_abus_slave_0_abus_interrupt     : out    std_logic                     := '0';              --                               .interrupt
		sega_saturn_abus_slave_0_abus_disableout   : out   std_logic                     := '0';              --                               .muxing
		sega_saturn_abus_slave_0_abus_muxing	     : out   std_logic_vector(1	 downto 0)  := (others => '0'); --                               .muxing
		sega_saturn_abus_slave_0_abus_direction	  : out   std_logic                     := '0';              --                               .direction

		--altera_up_sd_card_avalon_interface_0_conduit_end_b_SD_cmd   : inout std_logic                     := 'X';             -- b_SD_cmd
		--altera_up_sd_card_avalon_interface_0_conduit_end_b_SD_dat   : inout std_logic                     := 'X';             -- b_SD_dat
		--altera_up_sd_card_avalon_interface_0_conduit_end_b_SD_dat3  : inout std_logic                     := 'X';             -- b_SD_dat3
		--altera_up_sd_card_avalon_interface_0_conduit_end_o_SD_clock : out   std_logic  ;                                       -- o_SD_clock

		uart_0_external_connection_txd : out   std_logic                     := '0';                          -- 
		uart_0_external_connection_rxd : in    std_logic                     := 'X';                          -- 

		hex0_conn_export                                           : out std_logic_vector(6 downto 0);
		hex1_conn_export                                           : out std_logic_vector(6 downto 0);
		hex2_conn_export                                           : out std_logic_vector(6 downto 0);
		hex3_conn_export                                           : out std_logic_vector(6 downto 0);
		hex4_conn_export                                           : out std_logic_vector(6 downto 0);
		hex5_conn_export                                           : out std_logic_vector(6 downto 0);
		hexdot_conn_export                                         : out std_logic_vector(5 downto 0);

		leds_conn_export                                           : out std_logic_vector(3 downto 0); -- leds_conn_export[0]: ledr1, leds_conn_export[1]: ledg1, leds_conn_export[2]: ledo1, leds_conn_export[3]: ledo2
		extra_leds_conn_export                                     : out std_logic_vector(4 downto 0); -- Extra LEDs for DE10-lite only, mapped to their own control register
		switches_conn_export                                       : in  std_logic_vector(7 downto 0); -- switches_conn_export[0]: sw1, switches_conn_export[1]: sw2, switches_conn_export[2]: unused clock (SCSPCLK from SIM, or EXT from same board)

		spi_sync_conn_export                                       : in  std_logic;                    -- SPI synchronization
		spi_stm32_MOSI                                             : out std_logic       := '0';       -- MOSI
		spi_stm32_MISO                                             : in  std_logic;                    -- MISO
		spi_stm32_SCLK                              : out    std_logic                     := '0';             -- SCLK
		spi_stm32_SS_n                              : out    std_logic                     := '0'              -- SS_n

		--audio_out_BCLK                              : in    std_logic                     := '0';             -- BCLK
		--audio_out_DACDAT                            : out   std_logic;                                        -- DACDAT
		--audio_out_DACLRCK                           : in    std_logic                     := '0';              -- DACLRCK
		--audio_SSEL                           		  : out    std_logic                     := '0'
	);
end entity wasca_toplevel;

architecture rtl of wasca_toplevel is


	component wasca is
		port (
			abus_avalon_sdram_bridge_0_abus_address           : in    std_logic_vector(9 downto 0)  := (others => 'Z'); -- address
			abus_avalon_sdram_bridge_0_abus_read              : in    std_logic                     := 'Z';             -- read
			abus_avalon_sdram_bridge_0_abus_waitrequest       : out   std_logic;                                        -- waitrequest
			abus_avalon_sdram_bridge_0_abus_addressdata       : inout std_logic_vector(15 downto 0) := (others => 'Z'); -- addressdata
			abus_avalon_sdram_bridge_0_abus_chipselect        : in    std_logic_vector(2 downto 0)  := (others => 'Z'); -- chipselect
			abus_avalon_sdram_bridge_0_abus_direction         : out   std_logic;                                        -- direction
			abus_avalon_sdram_bridge_0_abus_disable_out       : out   std_logic;                                        -- disable_out
			abus_avalon_sdram_bridge_0_abus_interrupt         : out   std_logic;                                        -- interrupt
			abus_avalon_sdram_bridge_0_abus_muxing            : out   std_logic_vector(1 downto 0);                     -- muxing
			abus_avalon_sdram_bridge_0_abus_writebyteenable_n : in    std_logic_vector(1 downto 0)  := (others => 'Z'); -- writebyteenable_n
			abus_avalon_sdram_bridge_0_abus_reset             : in    std_logic                     := 'Z';             -- reset
			abus_avalon_sdram_bridge_0_sdram_addr             : out   std_logic_vector(12 downto 0);                    -- addr
			abus_avalon_sdram_bridge_0_sdram_ba               : out   std_logic_vector(1 downto 0);                     -- ba
			abus_avalon_sdram_bridge_0_sdram_cas_n            : out   std_logic;                                        -- cas_n
			abus_avalon_sdram_bridge_0_sdram_cke              : out   std_logic;                                        -- cke
			abus_avalon_sdram_bridge_0_sdram_cs_n             : out   std_logic;                                        -- cs_n
			abus_avalon_sdram_bridge_0_sdram_dq               : inout std_logic_vector(15 downto 0) := (others => 'Z'); -- dq
			abus_avalon_sdram_bridge_0_sdram_dqm              : out   std_logic_vector(1 downto 0);                     -- dqm
			abus_avalon_sdram_bridge_0_sdram_ras_n            : out   std_logic;                                        -- ras_n
			abus_avalon_sdram_bridge_0_sdram_we_n             : out   std_logic;                                        -- we_n
			abus_avalon_sdram_bridge_0_sdram_clk              : out   std_logic;                                        -- clk

			--audio_out_BCLK                                    : in    std_logic                     := 'Z';             -- BCLK
			--audio_out_DACDAT                                  : out   std_logic;                                        -- DACDAT
			--audio_out_DACLRCK                                 : in    std_logic                     := 'Z';             -- DACLRCK

			clk_clk                                           : in    std_logic                     := 'Z';             -- clk
			clock_116_mhz_clk                                 : out   std_logic;                                        -- clk

			--altera_up_sd_card_avalon_interface_0_conduit_end_b_SD_cmd   : inout std_logic                     := 'Z';             -- b_SD_cmd
			--altera_up_sd_card_avalon_interface_0_conduit_end_b_SD_dat   : inout std_logic                     := 'Z';             -- b_SD_dat
			--altera_up_sd_card_avalon_interface_0_conduit_end_b_SD_dat3  : inout std_logic                     := 'Z';             -- b_SD_dat3
			--sd_card_avalon_interface_0_conduit_end_o_SD_clock : out   std_logic      ;                                   -- o_SD_clock

			uart_0_external_connection_rxd                             : in    std_logic                     := '0';             -- rxd
			uart_0_external_connection_txd                             : out   std_logic;                                        -- txd

			hex0_conn_export                                           : out   std_logic_vector(6 downto 0);
			hex1_conn_export                                           : out   std_logic_vector(6 downto 0);
			hex2_conn_export                                           : out   std_logic_vector(6 downto 0);
			hex3_conn_export                                           : out   std_logic_vector(6 downto 0);
			hex4_conn_export                                           : out   std_logic_vector(6 downto 0);
			hex5_conn_export                                           : out   std_logic_vector(6 downto 0);
			hexdot_conn_export                                         : out   std_logic_vector(5 downto 0);

			leds_conn_export                                           : out   std_logic_vector(3 downto 0);
			extra_leds_conn_export                                     : out   std_logic_vector(4 downto 0);
			switches_conn_export                                       : in    std_logic_vector(7 downto 0);

			spi_sync_conn_export                                       : in    std_logic;                                        -- SPI synchronization
			buffered_spi_miso                                    : in   std_logic;                                        -- MISO
			buffered_spi_mosi                                    : out    std_logic                     := 'Z';             -- MOSI
			buffered_spi_clk                                    : out    std_logic                     := 'Z';             -- SCLK
			buffered_spi_cs                                    : out    std_logic                     := 'Z';             -- SS_n

			reset_reset_n                                     : in    std_logic                     := 'Z';             -- reset_n

			reset_controller_0_reset_in1_reset                : in    std_logic                     := 'Z' ;             -- reset
			altpll_1_areset_conduit_export                    : in    std_logic                     := 'Z';             -- export
			altpll_1_locked_conduit_export                    : out   std_logic;                                        -- export
			altpll_1_phasedone_conduit_export                 : out   std_logic                                         -- export
		);
	end component;


	signal altpll_1_areset_conduit_export : std_logic := '0';
	signal altpll_1_locked_conduit_export : std_logic := '0';
	signal altpll_1_phasedone_conduit_export : std_logic := '0';
	
	--signal sega_saturn_abus_slave_0_abus_address_demuxed : std_logic_vector(25 downto 0) := (others => '0');
	--signal sega_saturn_abus_slave_0_abus_data_demuxed : std_logic_vector(15 downto 0) := (others => '0');
		
	signal clock_116_mhz : std_logic := '0';
	
	signal por_counter : unsigned(31 downto 0) := (others => '0');
	signal por_reset : std_logic := '0';
	signal por_reset_n : std_logic := '0';

	
	begin
	
	--sega_saturn_abus_slave_0_abus_muxing (0) <= not sega_saturn_abus_slave_0_abus_muxing(1);
	
	external_sdram_controller_wire_clk <= not clock_116_mhz;
	
	my_little_wasca : component wasca
		port map (
			clk_clk => clk_clk,
			clock_116_mhz_clk => clock_116_mhz,

			abus_avalon_sdram_bridge_0_sdram_addr => external_sdram_controller_wire_addr,
			abus_avalon_sdram_bridge_0_sdram_ba => external_sdram_controller_wire_ba,
			abus_avalon_sdram_bridge_0_sdram_cas_n => external_sdram_controller_wire_cas_n,
			abus_avalon_sdram_bridge_0_sdram_cke => external_sdram_controller_wire_cke,
			abus_avalon_sdram_bridge_0_sdram_cs_n => external_sdram_controller_wire_cs_n,
			abus_avalon_sdram_bridge_0_sdram_dq => external_sdram_controller_wire_dq,
			abus_avalon_sdram_bridge_0_sdram_dqm => external_sdram_controller_wire_dqm,
			abus_avalon_sdram_bridge_0_sdram_ras_n => external_sdram_controller_wire_ras_n,
			abus_avalon_sdram_bridge_0_sdram_we_n => external_sdram_controller_wire_we_n,
			abus_avalon_sdram_bridge_0_abus_address => sega_saturn_abus_slave_0_abus_address,
			abus_avalon_sdram_bridge_0_abus_chipselect => "1"&sega_saturn_abus_slave_0_abus_chipselect(1 downto 0),--work only with CS1 and CS0 for now
			abus_avalon_sdram_bridge_0_abus_read => sega_saturn_abus_slave_0_abus_read,
			abus_avalon_sdram_bridge_0_abus_writebyteenable_n => sega_saturn_abus_slave_0_abus_write,
			abus_avalon_sdram_bridge_0_abus_waitrequest => sega_saturn_abus_slave_0_abus_waitrequest,
			abus_avalon_sdram_bridge_0_abus_interrupt => sega_saturn_abus_slave_0_abus_interrupt,
			abus_avalon_sdram_bridge_0_abus_addressdata => sega_saturn_abus_slave_0_abus_addressdata,
			abus_avalon_sdram_bridge_0_abus_direction => sega_saturn_abus_slave_0_abus_direction,
			abus_avalon_sdram_bridge_0_abus_muxing => sega_saturn_abus_slave_0_abus_muxing,
			abus_avalon_sdram_bridge_0_abus_disable_out => sega_saturn_abus_slave_0_abus_disableout,
			abus_avalon_sdram_bridge_0_abus_reset => reset_reset_n,

			--altera_up_sd_card_avalon_interface_0_conduit_end_b_SD_dat3 => altera_up_sd_card_avalon_interface_0_conduit_end_b_SD_dat3,
			--altera_up_sd_card_avalon_interface_0_conduit_end_b_SD_dat => altera_up_sd_card_avalon_interface_0_conduit_end_b_SD_dat,
			--altera_up_sd_card_avalon_interface_0_conduit_end_o_SD_clock => altera_up_sd_card_avalon_interface_0_conduit_end_o_SD_clock,
			--altera_up_sd_card_avalon_interface_0_conduit_end_b_SD_cmd => altera_up_sd_card_avalon_interface_0_conduit_end_b_SD_cmd,

			altpll_1_areset_conduit_export => altpll_1_areset_conduit_export,
			altpll_1_locked_conduit_export => altpll_1_locked_conduit_export,
			altpll_1_phasedone_conduit_export => altpll_1_phasedone_conduit_export,

			uart_0_external_connection_rxd => uart_0_external_connection_rxd,
			uart_0_external_connection_txd => uart_0_external_connection_txd,

			hex0_conn_export       => hex0_conn_export,
			hex1_conn_export       => hex1_conn_export,
			hex2_conn_export       => hex2_conn_export,
			hex3_conn_export       => hex3_conn_export,
			hex4_conn_export       => hex4_conn_export,
			hex5_conn_export       => hex5_conn_export,
			hexdot_conn_export     => hexdot_conn_export,

			leds_conn_export       => leds_conn_export,
			extra_leds_conn_export => extra_leds_conn_export,
			switches_conn_export   => switches_conn_export,

			spi_sync_conn_export   => spi_sync_conn_export,
			buffered_spi_miso => spi_stm32_MISO,
			buffered_spi_mosi => spi_stm32_MOSI,
			buffered_spi_clk => spi_stm32_SCLK,
			buffered_spi_cs => spi_stm32_SS_n,

			--audio_out_BCLK => audio_out_BCLK,
			--audio_out_DACDAT => audio_out_DACDAT,
			--audio_out_DACLRCK => audio_out_DACLRCK,

			reset_reset_n => por_reset_n,
			reset_controller_0_reset_in1_reset => por_reset
		);

		--empty subsystem
--		external_sdram_controller_wire_addr <= (others => 'Z');
--		external_sdram_controller_wire_ba <= (others => 'Z');
--		external_sdram_controller_wire_cas_n <= (others => 'Z');
--		external_sdram_controller_wire_cke <= (others => 'Z');
--		external_sdram_controller_wire_cs_n <= (others => 'Z');
--		external_sdram_controller_wire_dq <= (others => 'Z');
--		external_sdram_controller_wire_dqm <= (others => 'Z');
--		external_sdram_controller_wire_ras_n <= (others => 'Z');
--		external_sdram_controller_wire_we_n  <= (others => 'Z');
--		external_sdram_controller_wire_clk <= (others => 'Z');
--		sega_saturn_abus_slave_0_abus_addressdata <= (others => 'Z');
--		sega_saturn_abus_slave_0_abus_waitrequest <= (others => 'Z');
--		sega_saturn_abus_slave_0_abus_interrupt <= (others => 'Z');
--		sega_saturn_abus_slave_0_abus_disableout <= '1';
--		sega_saturn_abus_slave_0_abus_muxing <= "00";
--		sega_saturn_abus_slave_0_abus_direction <= '0';
--		spi_sd_card_MOSI <= 'Z';
--		spi_sd_card_SCLK <= 'Z';
--		spi_sd_card_SS_n <= 'Z';
--		uart_0_external_connection_txd <= 'Z';
--		spi_stm32_MISO <= 'Z';
--		audio_out_DACDAT <= 'Z';

		
		--audio_SSEL <= '1';
		--sega_saturn_abus_slave_0_abus_waitrequest <= '1';
		--sega_saturn_abus_slave_0_abus_direction <= '0';
		--sega_saturn_abus_slave_0_abus_muxing <= "01";
		
		--por
		process (clock_116_mhz)
		begin
			if std_logic(por_counter(24)) = '0' then
				por_counter <= por_counter + 1;
			end if;
		end process;
		
		por_reset <= (std_logic(por_counter(22)));
		por_reset_n <= not (std_logic(por_counter(22)));
		
		
end architecture rtl; -- of wasca_toplevel
