cafe-alpha/wascafe/v13/r07c_de10_20201014_abus4/wasca/wasca_inst.vhd

	component wasca is
		port (
			abus_avalon_sdram_bridge_0_abus_address           : in    std_logic_vector(9 downto 0)  := (others => 'X'); -- address
			abus_avalon_sdram_bridge_0_abus_read              : in    std_logic                     := 'X';             -- read
			abus_avalon_sdram_bridge_0_abus_waitrequest       : out   std_logic;                                        -- waitrequest
			abus_avalon_sdram_bridge_0_abus_addressdata       : inout std_logic_vector(15 downto 0) := (others => 'X'); -- addressdata
			abus_avalon_sdram_bridge_0_abus_chipselect        : in    std_logic_vector(2 downto 0)  := (others => 'X'); -- chipselect
			abus_avalon_sdram_bridge_0_abus_direction         : out   std_logic;                                        -- direction
			abus_avalon_sdram_bridge_0_abus_disable_out       : out   std_logic;                                        -- disable_out
			abus_avalon_sdram_bridge_0_abus_interrupt         : out   std_logic;                                        -- interrupt
			abus_avalon_sdram_bridge_0_abus_muxing            : out   std_logic_vector(1 downto 0);                     -- muxing
			abus_avalon_sdram_bridge_0_abus_writebyteenable_n : in    std_logic_vector(1 downto 0)  := (others => 'X'); -- writebyteenable_n
			abus_avalon_sdram_bridge_0_abus_reset             : in    std_logic                     := 'X';             -- reset
			abus_avalon_sdram_bridge_0_sdram_addr             : out   std_logic_vector(12 downto 0);                    -- addr
			abus_avalon_sdram_bridge_0_sdram_ba               : out   std_logic_vector(1 downto 0);                     -- ba
			abus_avalon_sdram_bridge_0_sdram_cas_n            : out   std_logic;                                        -- cas_n
			abus_avalon_sdram_bridge_0_sdram_cke              : out   std_logic;                                        -- cke
			abus_avalon_sdram_bridge_0_sdram_cs_n             : out   std_logic;                                        -- cs_n
			abus_avalon_sdram_bridge_0_sdram_dq               : inout std_logic_vector(15 downto 0) := (others => 'X'); -- dq
			abus_avalon_sdram_bridge_0_sdram_dqm              : out   std_logic_vector(1 downto 0);                     -- dqm
			abus_avalon_sdram_bridge_0_sdram_ras_n            : out   std_logic;                                        -- ras_n
			abus_avalon_sdram_bridge_0_sdram_we_n             : out   std_logic;                                        -- we_n
			abus_avalon_sdram_bridge_0_sdram_clk              : out   std_logic;                                        -- clk
			altpll_1_areset_conduit_export                    : in    std_logic                     := 'X';             -- export
			altpll_1_locked_conduit_export                    : out   std_logic;                                        -- export
			altpll_1_phasedone_conduit_export                 : out   std_logic;                                        -- export
			buffered_spi_mosi                                 : out   std_logic;                                        -- mosi
			buffered_spi_clk                                  : out   std_logic;                                        -- clk
			buffered_spi_miso                                 : in    std_logic                     := 'X';             -- miso
			buffered_spi_cs                                   : out   std_logic;                                        -- cs
			clk_clk                                           : in    std_logic                     := 'X';             -- clk
			clock_116_mhz_clk                                 : out   std_logic;                                        -- clk
			extra_leds_conn_export                            : out   std_logic_vector(4 downto 0);                     -- export
			hex0_conn_export                                  : out   std_logic_vector(6 downto 0);                     -- export
			hex1_conn_export                                  : out   std_logic_vector(6 downto 0);                     -- export
			hex2_conn_export                                  : out   std_logic_vector(6 downto 0);                     -- export
			hex3_conn_export                                  : out   std_logic_vector(6 downto 0);                     -- export
			hex4_conn_export                                  : out   std_logic_vector(6 downto 0);                     -- export
			hex5_conn_export                                  : out   std_logic_vector(6 downto 0);                     -- export
			hexdot_conn_export                                : out   std_logic_vector(5 downto 0);                     -- export
			leds_conn_export                                  : out   std_logic_vector(3 downto 0);                     -- export
			reset_reset_n                                     : in    std_logic                     := 'X';             -- reset_n
			reset_controller_0_reset_in1_reset                : in    std_logic                     := 'X';             -- reset
			spi_sync_conn_export                              : in    std_logic                     := 'X';             -- export
			switches_conn_export                              : in    std_logic_vector(7 downto 0)  := (others => 'X'); -- export
			uart_0_external_connection_rxd                    : in    std_logic                     := 'X';             -- rxd
			uart_0_external_connection_txd                    : out   std_logic                                         -- txd
		);
	end component wasca;
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
