cafe-alpha/wascafe/v13/WascaLoader/benchmark.c

/**
 *  Cartridge Test Utility
 *  by cafe-alpha.
 *  WWW: http://ppcenter.free.fr/pskai/
 *
 *  See LICENSE file for details.
**/

//                                                                                
//    Copyright (c) 2006 Thomas Fuchs / The Rockin'-B, www.rockin-b.de       
//                                                                                
//    Permission is granted to anyone to use this software for any purpose        
//    and to redistribute it freely, subject to the following restrictions:       
//                                                                                
//    1.  The origin of this software must not be misrepresented. You must not    
//        claim that you wrote the original software. If you use this software    
//        in a product, an acknowledgment in the product documentation would be   
//        appreciated but is not required.                                        
//                                                                                
//    2.  ANY COMMERCIAL USE IS PROHIBITED. This includes that you must not use   
//        this software in the production of a commercial product. Only an explicit
//        permission by the author can allow you to do that.                      
//                                                                                
//    3.  Any modification applied to the software must be marked as such clearly.
//                                                                                
//    4.  This license may not be removed or altered from any distribution.       
//
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
