cafe-alpha/wascafe/(commit log)

2016-07-09 Board v1.2 (preliminary version)
    [contour.kicad_pcb, wasca.dsn, wasca.kicad_pcb, wasca.sch]
2016-07-11 PCB update, added firmware stub
    Added USB mezzanine board
    Fixed SCSPCLK wiring
    Minor changes in cartridge routing
    Added MAX10 firmware stub
    [contour.kicad_pcb, usbcart.dsn, usbcart.kicad_pcb, usbcart.sch, wasca.csv, wasca.kicad_pcb, wasca.sch]
2016-08-04 Added v1.0 and v1.1 boards
    [contour.kicad_pcb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]
2016-11-17 Added Board v1.0 description and pictures
2016-11-18 Added FPGA firmware for board v1.0
    [wasca.csv]
2016-11-18 Added v1.2 board, pictures and README.md
    [contour.kicad_pcb, max10_board.dsn, max10_board.kicad_pcb, max10_board.sch]
2016-11-19 Added MAX10 evaluation board picture
2020-08-09 Add board v1.3
    [contour.kicad_pcb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]
2020-08-09 Add firmware sources for board v1.3
    [wasca.csv]
2020-08-14 Don't update wasca_link.h when it is not found in SatLink folder (in that case, it's safe to use existing one) Don't update m10_ver_infos.h when date format is not as expected
2020-08-22 Added "Feedback Test", which writes to CS1 when memory test error happened
    [main.c, memtest_feedback.c, memtest_feedback.h]
2020-08-22 Scroll error display during infinite test
    [main.c, memtest_feedback.c]
2020-09-07 Added sample firmware for NUCLEO-F446RE board (Requires CubeMx to generate HAL source code from wasca.ioc)
    [Configuration.txt]
2020-09-21 Backup memory support on SD card via STM32
    [Configuration.txt, wasca.csv]
2020-09-28 Gather several blocks in a single SD card write on STM32 side (WIP)
2020-10-13 SPI support WIP. Everything else untested.
    [wasca.csv]
2020-10-14 SPI seems to work better now
2020-10-25 Dual SPI works. Boot ROM loading and save data access implemented but not tested yet.
    [wasca.csv, wasca_signaltap.stp]
