cafe-alpha/wascafe/(notices)

Notices in the files:
v10/board/wasca.kicad_pcb:
Distributed under GNU GENERAL PUBLIC LICENSE Version 2
v13/board/contour.kicad_pcb:
Distributed under the CC-BY-SA license
